Engineering-3/RCM-Comm/README.md

RCM-Comm
========================

RCM-Comm

This is an interface board that brings wireless communication to the RCM Control Stack. The RCM-Comm accepts the [Lantronix XPico WiFi Embedded Device Server](https://www.lantronix.com/wp-content/uploads/pdf/xPico-Wi-Fi_UG.pdf). Please see [Engineering3](http://engineering3.org/) for more information on the complete RCM Control Stack project.

Repository Contents
-------------------

* **/RCM-Comm_v1** Eagle schematic/board files, BOM, gerbers

Version History
---------------
* [RCM-Comm_v1](https://github.com/Engineering-3/RCM-Comm/tree/master/RCM-Comm_v1) - First public version - version 1 

License Information
-------------------
Hardware is released under [Solderpad Hardware License v0.51](http://solderpad.org/licenses/SHL-0.51/).
Distributed as-is; no warranty is given.

Getting Started Help
--------------------
This is a Plug-n-Play board.
