Engineering-3/RCM-Comm/RCM-Comm_v3_E/README - RCM-COMM PCB Specification.txt

RCM-COMM PCB Specification
-------------------------------

BOARD STACK:

1. Copper Top
2. Copper Bottom

SILKSCREENS:

1.  Both Layers

PASTE MASKS:

1. Top Layer

BOARD MATERIALS:

RoHS Compliant: YES
Copper: 1oz
Finish: Immersion Gold
Material: FR-406
Thickness: 62 mil
Tg>170
Soldermask: SMOBC BLUE
Silkscreen: White

BOARD TESTING:

Electrical Test: YES
