Engineering-3/RCM-Comm/RCM-Comm_v3_E/RCM-Comm_v3_E_bottom_render.png

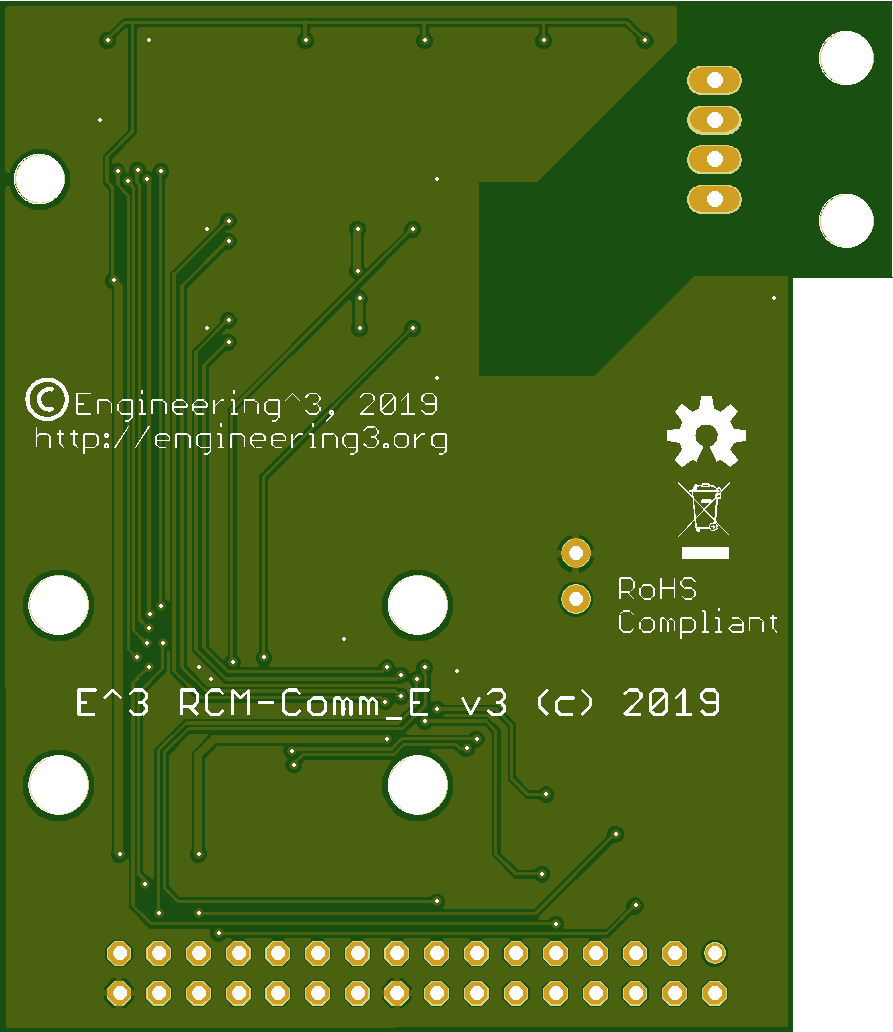
RCM-Comm_v3_E/RCM-Comm_v3_E_bottom_render.png
