Engineering-3/RCM-Comm/RCM-Comm_v3_W/BoardBottomRender.png

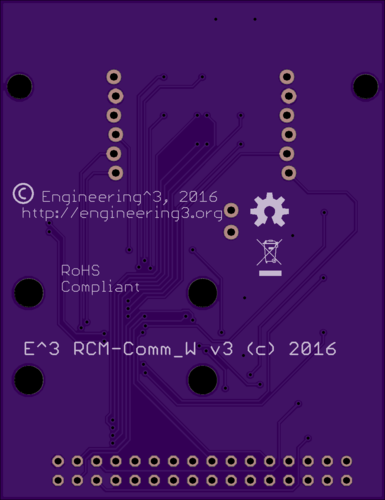
RCM-Comm_v3_W/BoardBottomRender.png
