Engineering-3/RCM-Comm/RCM-Comm_v3_W/BoardTopRender.png

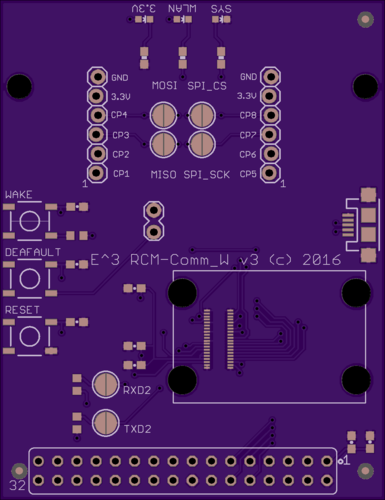
RCM-Comm_v3_W/BoardTopRender.png
