Engineering-3/RCM-Comm/RCM-Comm_v4/RCM-Comm_v4b_bottom_render.png

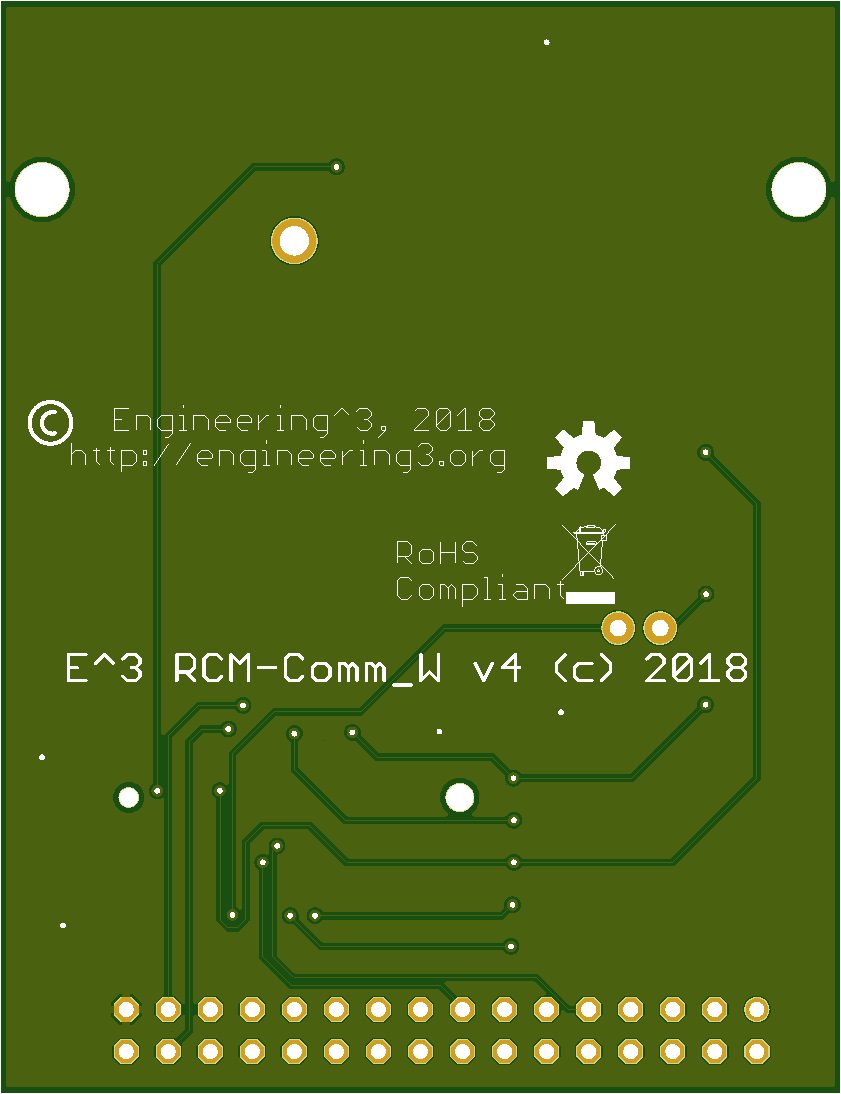
RCM-Comm_v4/RCM-Comm_v4b_bottom_render.png
