Engineering-3/RCM-Comm/RCM-Comm_v3_E/RCM-Comm_v3_E-BOM.xlsx

RCM-Comm_v3 _E-BOM |  |  |  |  |  |  | Price | Extended price
Reference | Quantity | Description | Manufacturer | Partnumber | Dist Part Number | Distributor
J1 | 1 | SOCKET, 2.54MM, 2X16POS | SAMTEC | SSQ-116-03-G-D |  | Avnet Express | $4.18 | $4.18
U1 | 1 | Lantronix Xpico WiFi module | Lantronix | XPW100100B-01 |  | Mouser | $29.56 | $29.56
FX1 | 1 | MODULE XFRMR LAN 10/100B-TX SMD | Bel Fuse Inc | S558-5999-T7-F | 507-1459-1-ND | Digikey | $2.71 | $2.71
R1, R2 | 2 | 2.7K 0603 RES | Yageo | RC0603JR-072K7L |  | Digikey | $0.10 | $0.20
R4 | 1 | 1K 0603 RES | Yageo | RC0603JR-071KL |  | Digikey | $0.10 | $0.10
S1, S2, S3 | 3 | tact switch | TE Connectivity | FSMCTTR |  | Digikey | $0.63 | $1.89
J4 | 1 | .1" 2-pin male header | 3M | 961102-6404-AR |  | Digikey | $0.16 | $0.16
C6, C7 | 2 | CAP CER 10UF 0603 | Samsung | CL10A106MQ8NNNC |  | Digikey | $0.18 | $0.36
R3, R5, R6 | 3 | RES 330 OHM 1/4W 5% 0603 SMD | Rhom Semiconductor | ESR03EZPJ331 |  | Digikey | $0.03 | $0.09
LED1, LED2, LED3 | 4 | LED SMARTLED GREEN 570NM 0603 | OSRAM Opto Semi | LG L29K-G2J1-24-Z |  | Digikey | $0.36 | $1.44
C1, C2, C4, C5, C8, C9 | 6 | CAP CER 0.1UF 16V 10% X7R 0603 | Murata Electronics | GRM188R71C104KA01D |  | Digikey | $0.10 | $0.60
U1 (connector) | 1 | CONN RCPT 40POS 0.4MM SMD GOLD | Hirose | DF40C(2.0)-40DS-0.4V(51) |  | Digikey | $1.18 | $1.18
xPico module mounting clip | 1 | xPico WiFi mounting clip (comes in box of 50) | Lantronix | XPC100A001-01-B |  | Mouser | $0.35 | $0.35
 |  |  |  |  |  |  |  | $0.00
PCB | 1 |  |  |  |  |  |  | $0.00
 |  |  |  |  |  |  |  | $0.00
 |  |  | Total |  |  |  |  | $42.82
