Engineering-3/RCM-Comm/RCM-Comm_v4/RCM-Comm_v4_BOM.xlsx

RCM-Comm v4 BOM
Item # | Qty | Ref Des | Manufacturer | Mfg Part # | Dist. Part # | Description
1 | 1 | J2 | TE Connectivity AMP Connectors | 2199230-4 | A115904CT-ND | CONN FEMALE 67POS 0.020 GOLD
2 | 1 | J1 | Samtec | SSQ-116-03-G-D | SSQ-116-03-G-D | 2 x 16 .1" female header with long pins
3 | 3 | LED1, LED2, LED3 | Lite-On Inc. | LTST-C193KGKT-5A | 160-1828-1-ND | LED GREEN CLEAR CHIP SMD
4 | 3 | R1, R3, R5 | Yageo | RC0603FR-07330RL | 311-330HRCT-ND | RES SMD 330 OHM 1% 1/10W 0603
5 | 4 | R4, R7, R8, R9, R10 | Yageo | RC0603JR-07100KL | 311-100KGRCT-ND | RES SMD 100K OHM 5% 1/10W 0603
6 | 1 | J3 | Wurth Electronics Inc. | 61300211121 | 732-5315-ND | CONN HEADER VERT 2POS 2.54MM
7 | 6 | C1, C4, C5, C9, C2, C8 | Murata Electronics North America | GRM033R61A104ME15D | 490-5405-1-ND | CAP CER 0.1UF 10V X5R 0201
8 | 3 | S1, S2, S3 | TE Connectivity ALCOSWITCH Switches | FSMCTTR | 450-2133-1-ND | SWITCH TACTILE SPST-NO 0.02A 15V
9 | 1 | Radio | Lantronix | XPC240300S-02 | XPC240300S-02-ND | XPC240300S-02-ND
10 | 1 |  | McMaseter-Carr | 92321A005 (https://www.mcmaster.com/92321A005) | 92321A005 (https://www.mcmaster.com/92321A005) | 18-8 Stainless Steel Unthreaded Spacer, 1/8" OD, 1/8" Long, for Number 0 Screw Size
11 | 1 |  | McMaseter-Carr | 91841A115 (https://www.mcmaster.com/91841A115) | 91841A115 (https://www.mcmaster.com/91841A115) | 18-8 Stainless Steel Hex Nut, 0-80 Thread Size
12 | 1 |  | McMaseter-Carr | 91772A058 (https://www.mcmaster.com/91772A058) | 91772A058 (https://www.mcmaster.com/91772A058) | Passivated 18-8 Stainless Steel Pan Head Phillips Screw, 0-80 Thread, 7/32" Long
13 | 2 | C6, C7 | Samsung Electro-Mechanics | CL21A106KOQNNNG | 1276-6455-1-ND | CAP CER 10UF 16V X5R 0805
