Engineering-3/RCM-Comm/RCM-Comm_v4/RCM-Comm_v4_sch.pdf

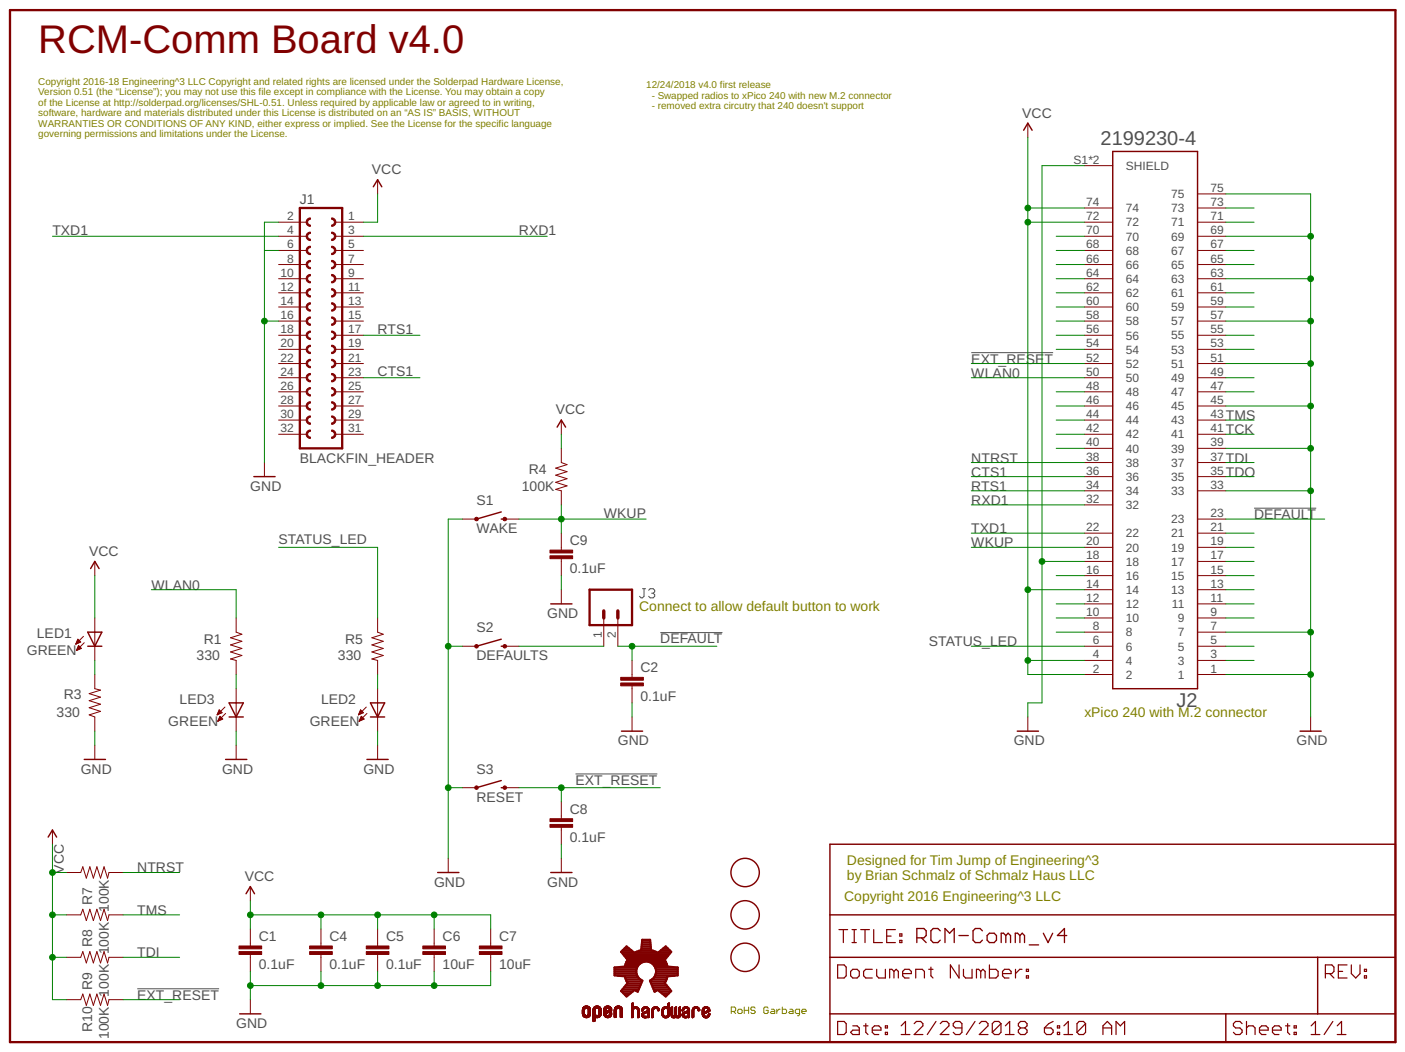
[picture p12: page 1]

Copyright 2016-18 Engineering^3 LLC Copyright and related rights are licensed under the Solderpad Hardware License, Version 0.51 (the “License”); you may not use this file except in compliance with the License. You may obtain a copy of the License at http://solderpad.org/licenses/SHL-0.51. Unless required by applicable law or agreed to in writing, software, hardware and materials distributed under this License is distributed on an “AS IS” BASIS, WITHOUT WARRANTIES OR CONDITIONS OF ANY KIND, either express or implied. See the License for the specific language

12/24/2018 v4.0 first release
- Swapped radios to xPico 240 with new M.2 connector
- removed extra circutry that 240 doesn't support

governing permissions and limitations under the License.

72
70 68 66 64 62 60 58 56 54 52

Connect to allow default button to work

Designed for Tim Jump of Engineering^3
by Brian Schmalz of Schmalz Haus LLC
Copyright 2016 Engineering^3 LLC
