Engineering-3/RCM-Comm/RCM-Comm_v3_E/RCM-Comm_v3_E_brd.pdf

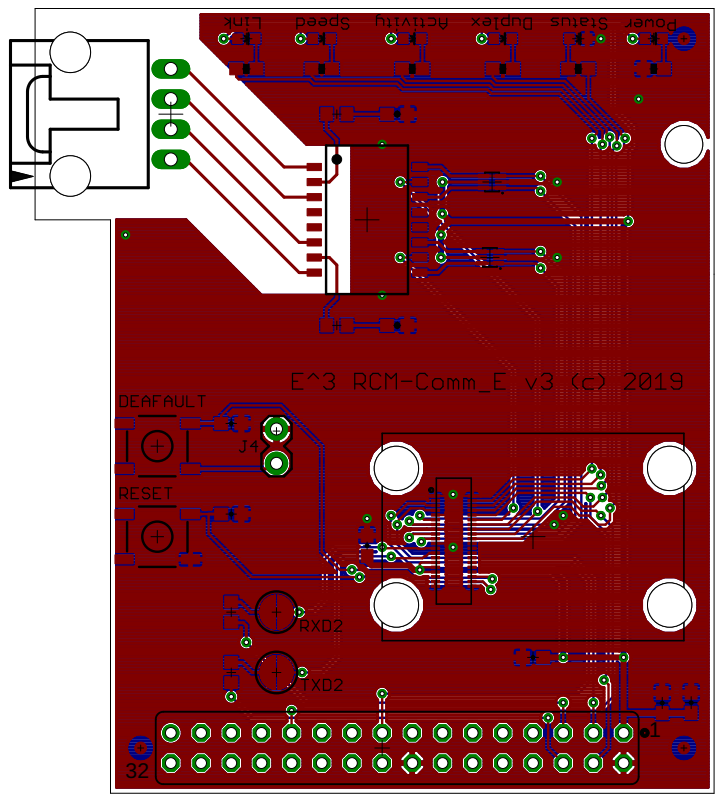
[picture p13: page 1]
