Engineering-3/RCM-Comm/RCM-Comm_v4/RCM-Comm_v4_brd.pdf

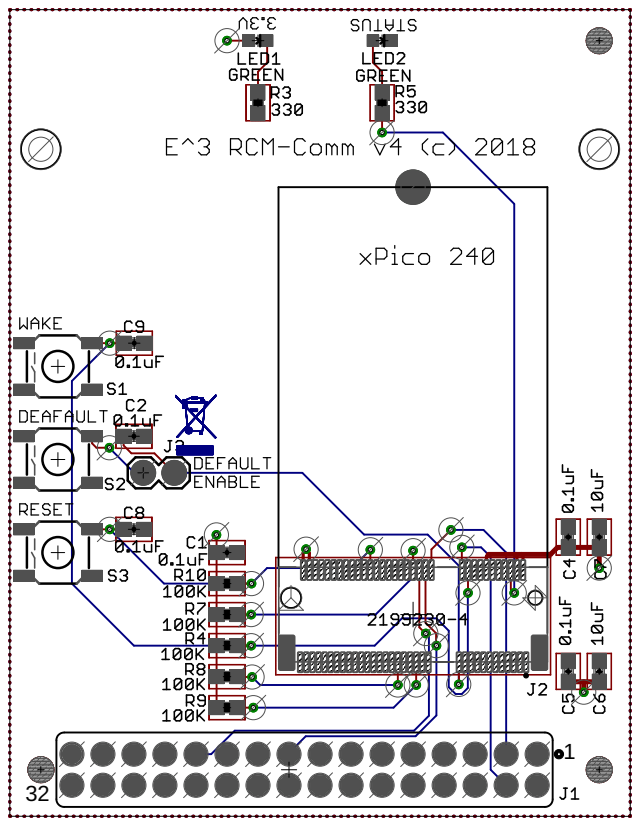
[picture p14: page 1]
