Engineering-3/RCM-Comm/RCM-Comm_v3_W/RCM-Comm_v3_W_brd.pdf

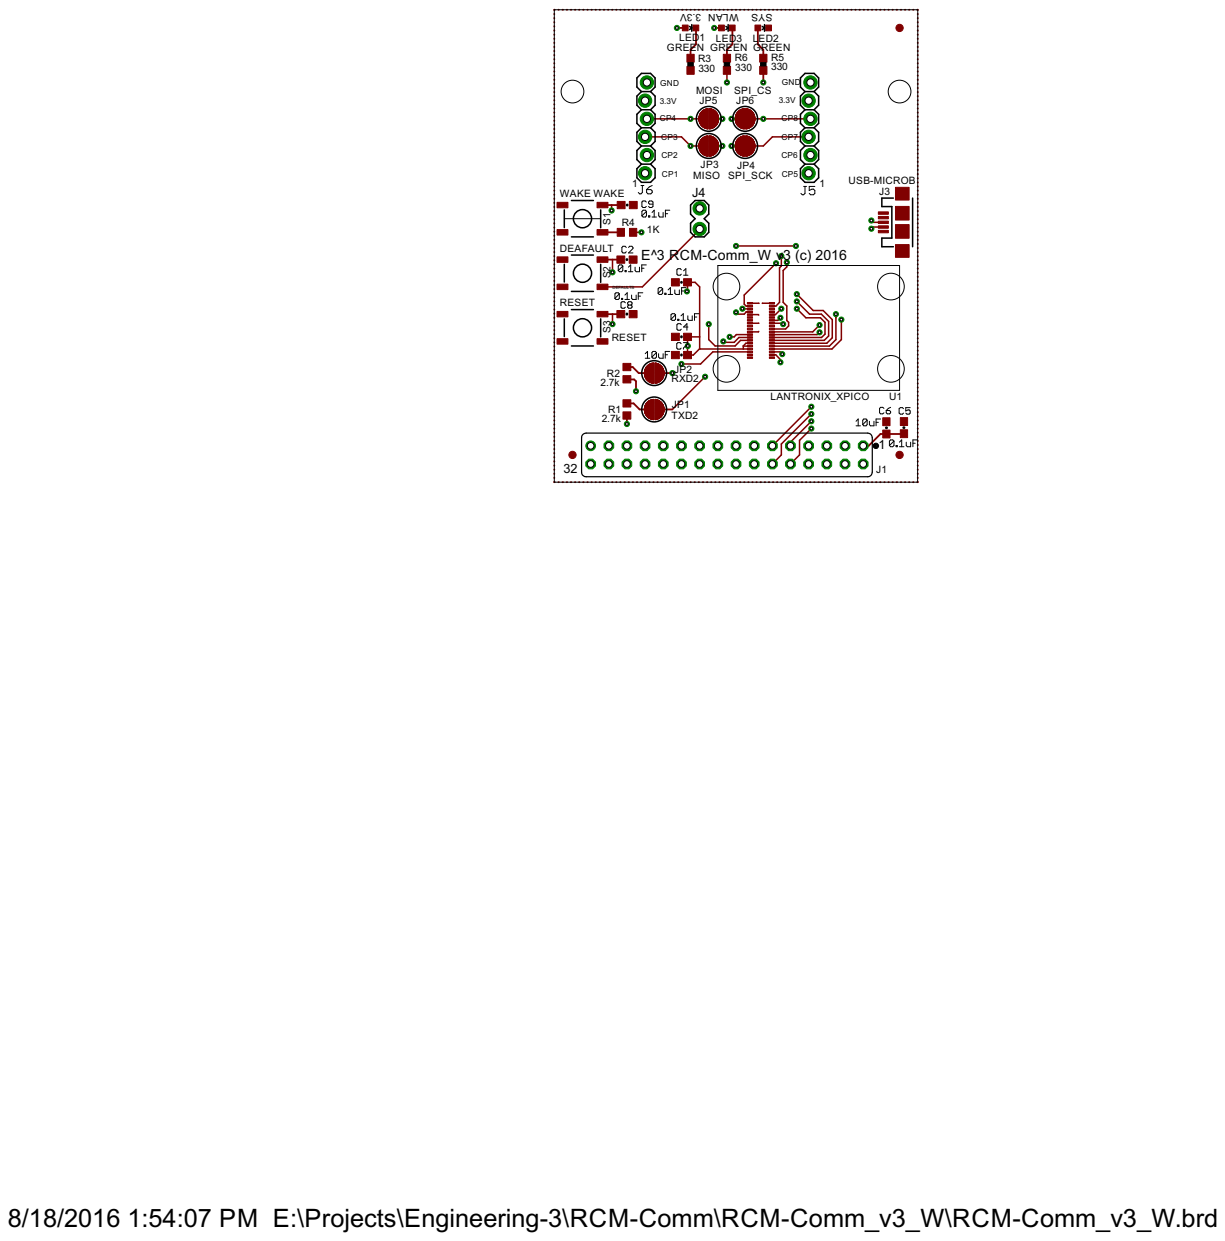
[picture p15: page 1]

8/18/2016 1:54:07 PM E:\Projects\Engineering-3\RCM-Comm\RCM-Comm_v3_W\RCM-Comm_v3_W.brd
