Engineering-3/RCM-Comm/RCM-Comm_v3_W/RCM-Comm_v3_W_brd_top.pdf

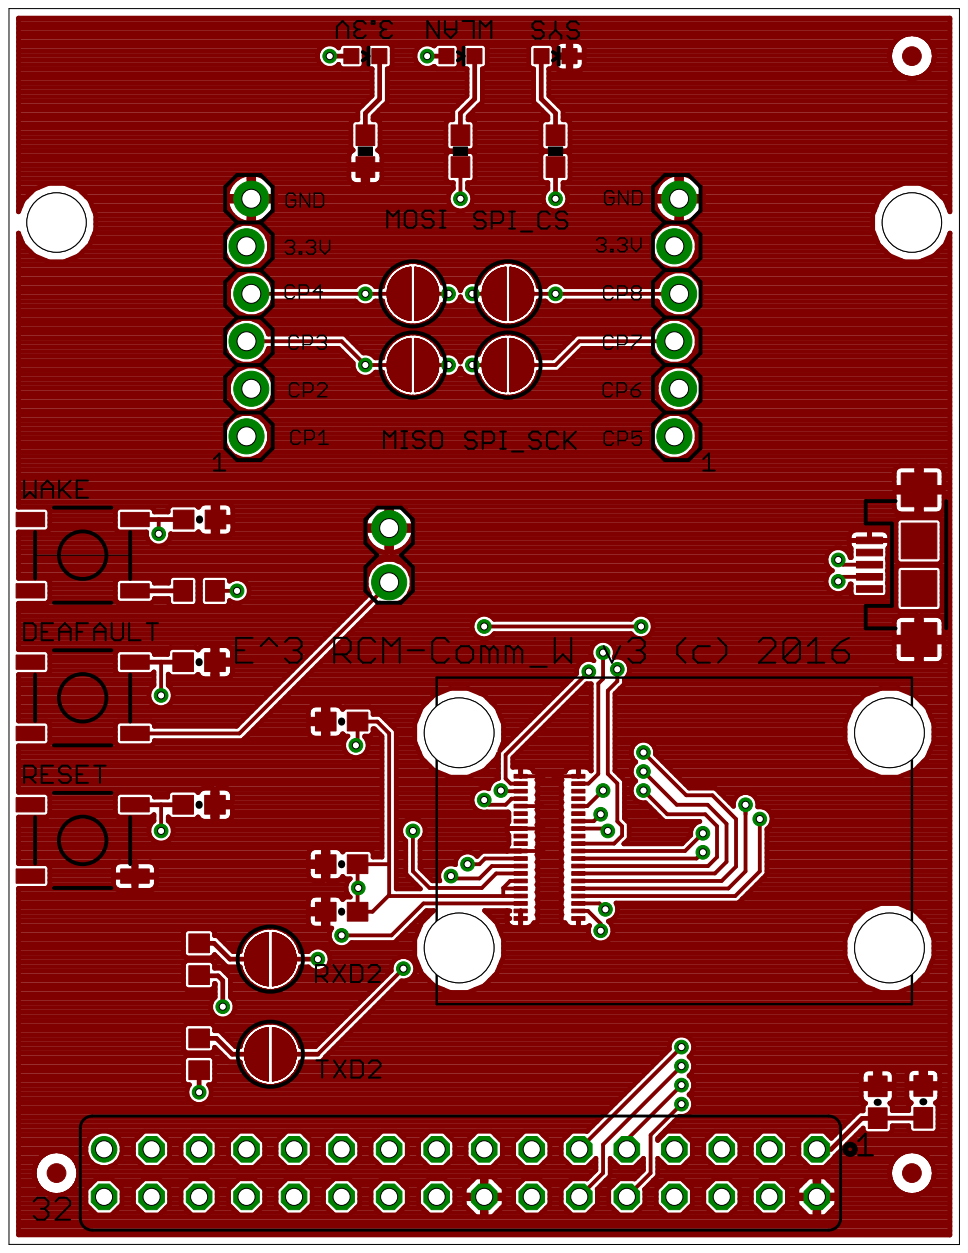
[picture p16: page 1]
