Engineering-3/RCM-Comm/RCM-Comm_v2_W/RCM-Comm_v2_W_brd.pdf

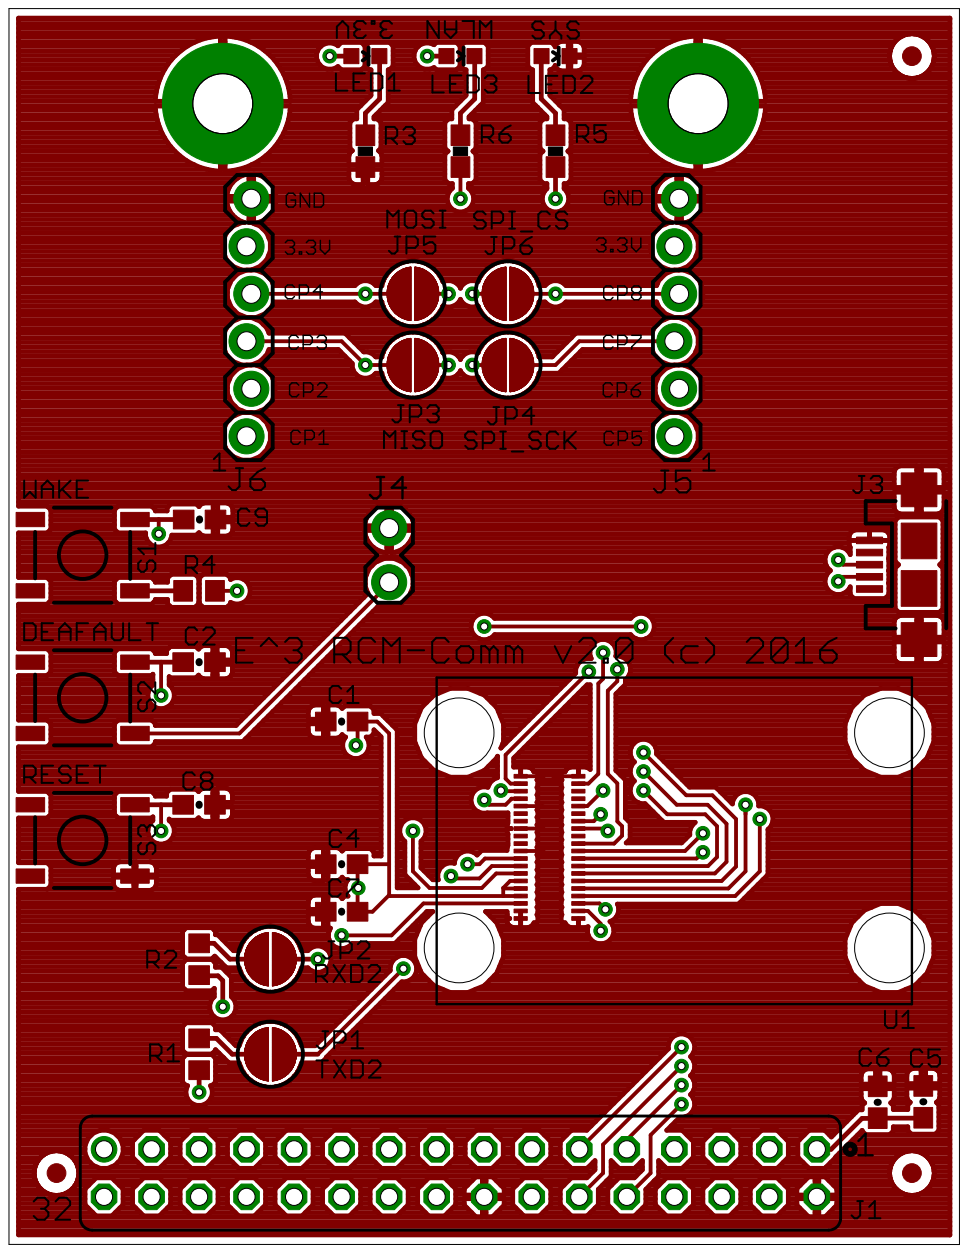
[picture p17: page 1]
