Engineering-3/RCM-Comm/RCM-Comm_v2_W/RCM-Comm_v2_W_sch.pdf

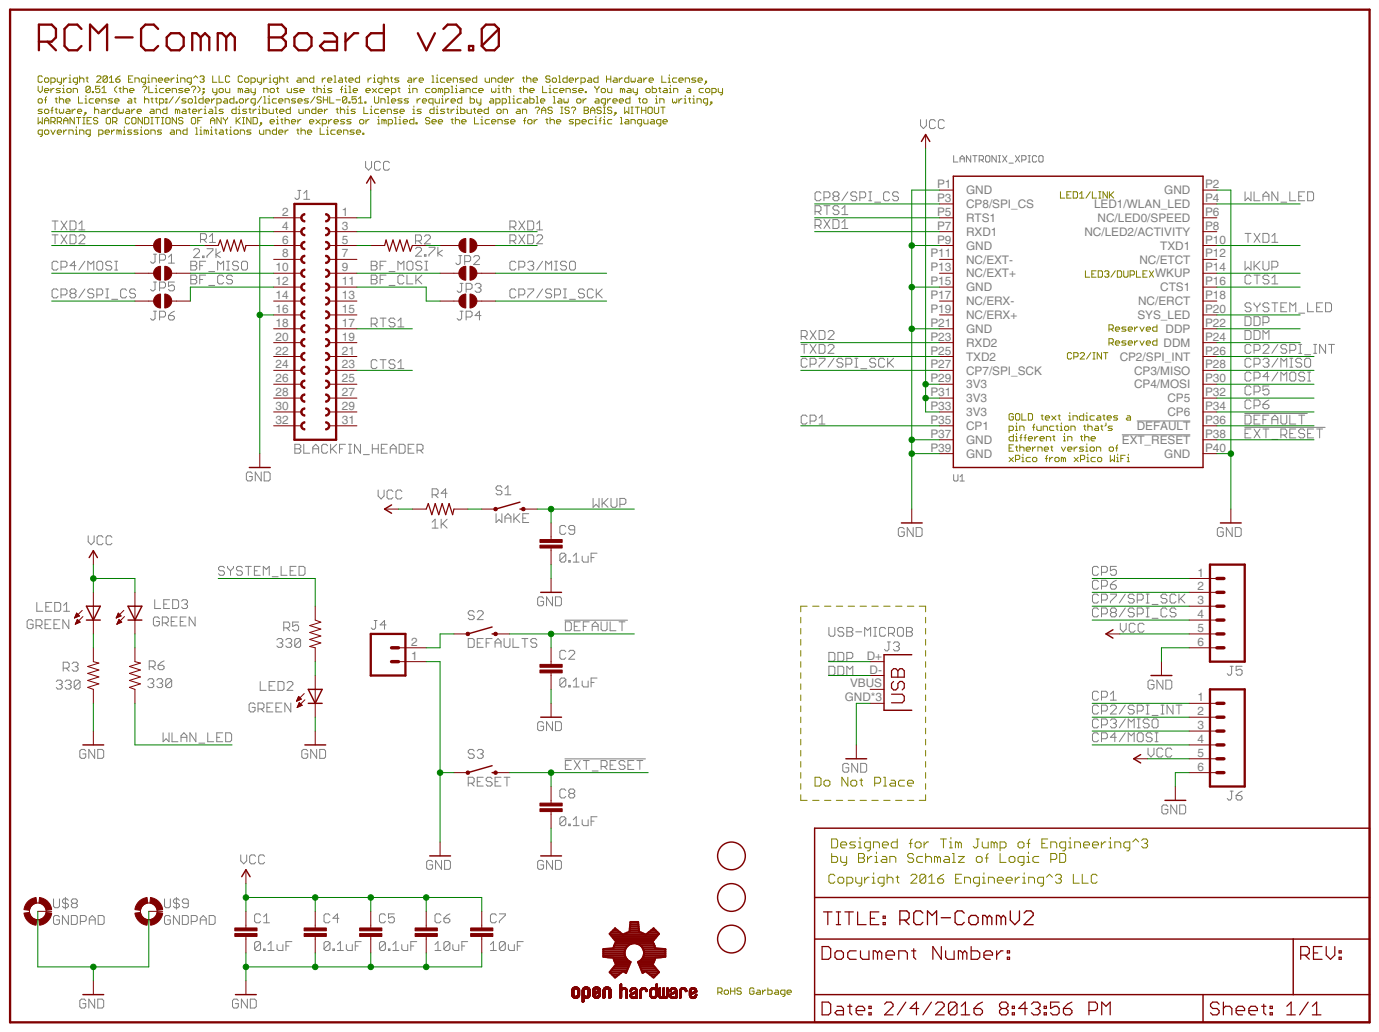
[picture p18: page 1]
