Engineering-3/RCM-Comm/RCM-Comm_v1/RCM-comm_v1_brd.pdf

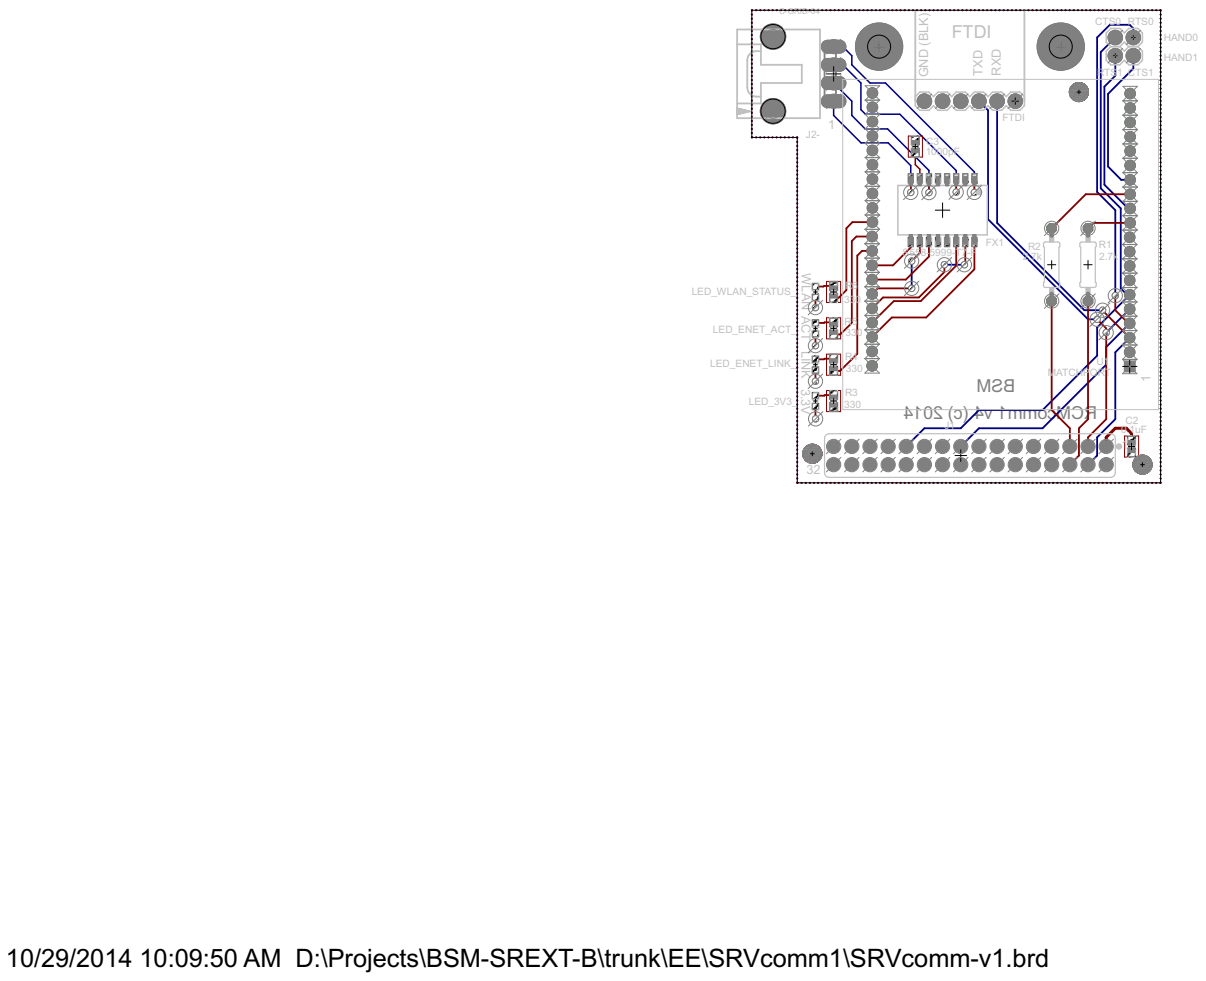
[picture p19: page 1]

10/29/2014 10:09:50 AM D:\Projects\BSM-SREXT-B\trunk\EE\SRVcomm1\SRVcomm-v1.brd
