Engineering-3/RCM-Comm/RCM-Comm_v1/RCM-comm_v1_sch.pdf

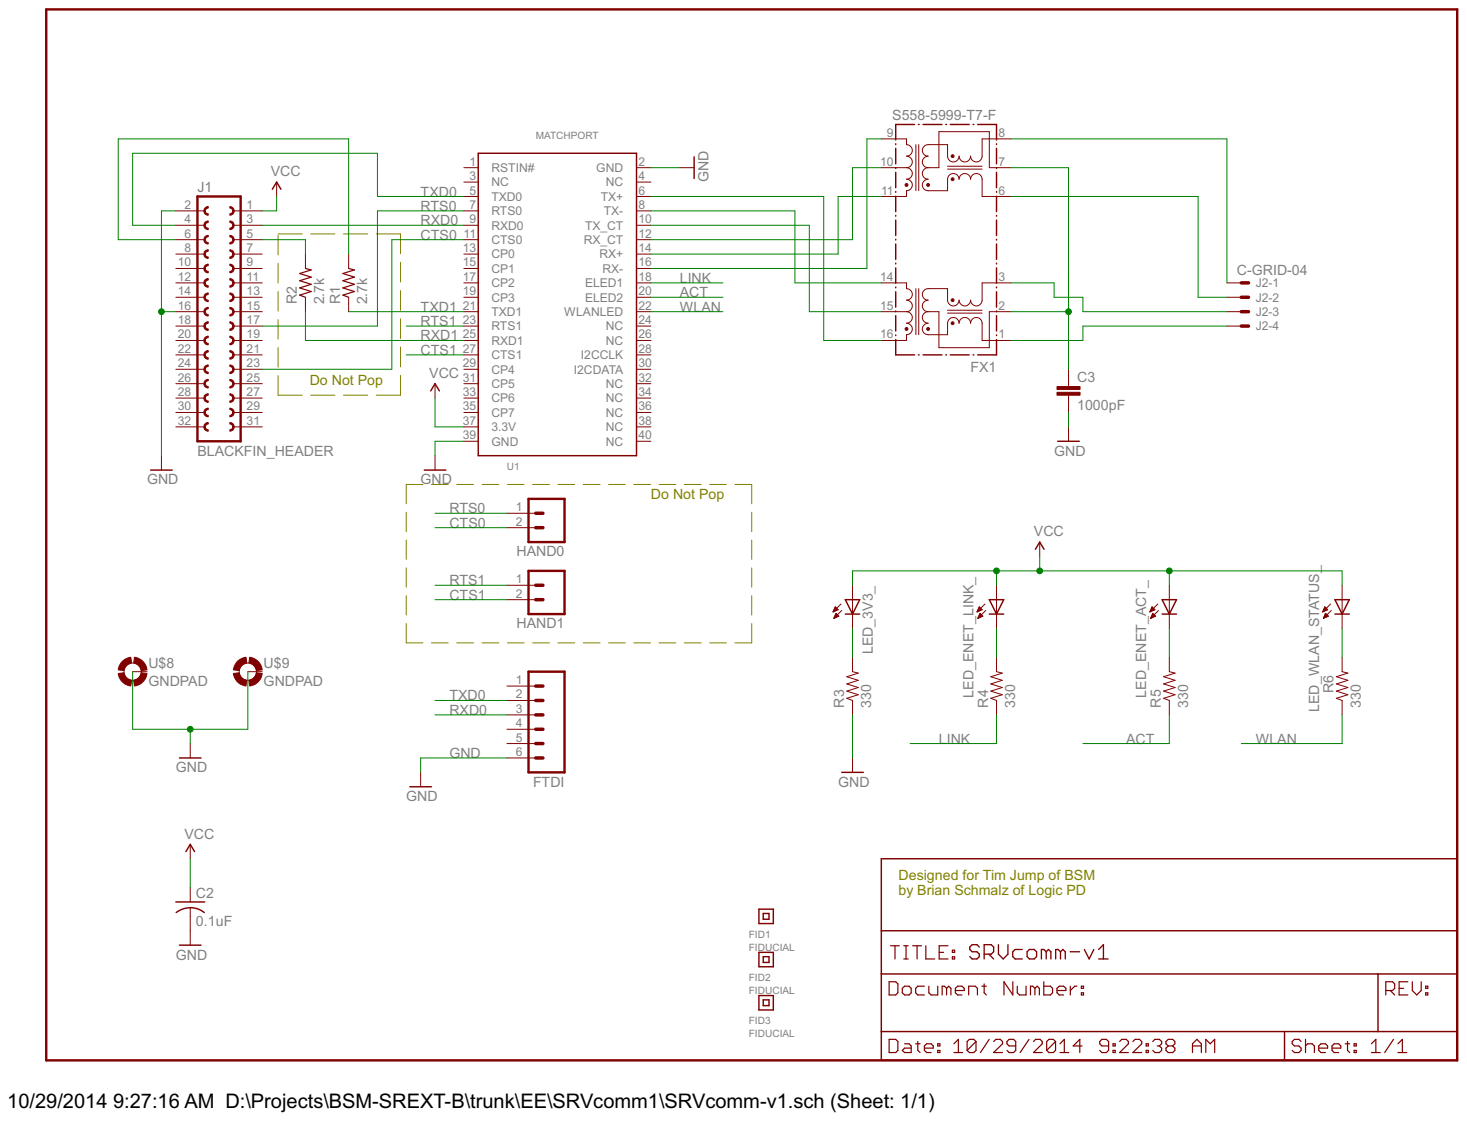
[picture p20: page 1]

Designed for Tim Jump of BSM
by Brian Schmalz of Logic PD

10/29/2014 9:27:16 AM D:\Projects\BSM-SREXT-B\trunk\EE\SRVcomm1\SRVcomm-v1.sch (Sheet: 1/1)
