Engineering-3/RCM-Comm/RCM-Comm_v3_E/RCM-Comm_v3_E.brd

## EAGLE design RCM-Comm_v3_E/RCM-Comm_v3_E.brd (2019-03-16)

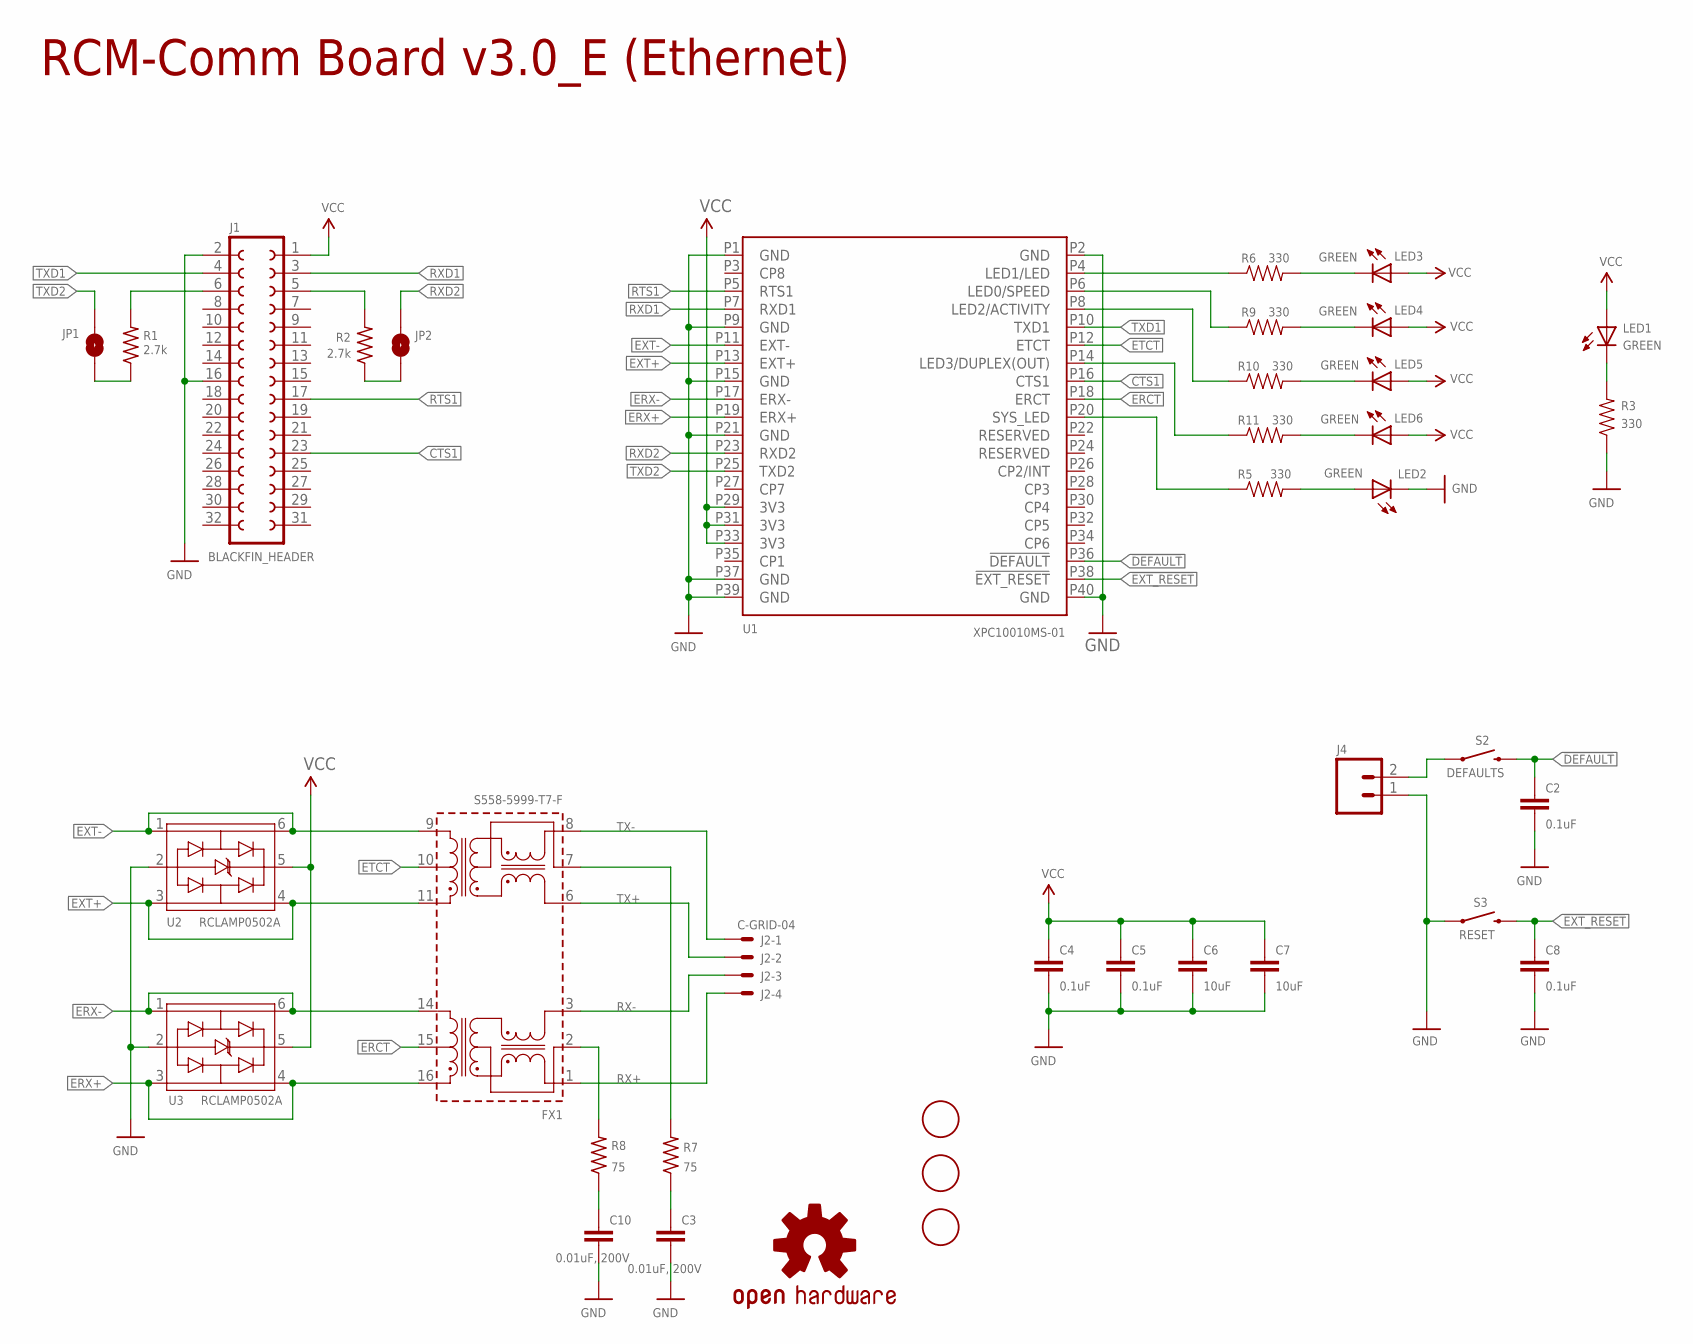
[picture p21: schematic RCM-Comm_v3_E.sch]

Parts:
C2, C4, C5, C8: 0.1uF; 0603-CAP
C3, C10: 0.01uF, 200V; 0603-CAP
C6, C7: 10uF; 0603-CAP
FID1, FID2, FID3: FIDUCIAL; FIDUCIAL_1MM
FX1: S558-5999-T7-F; N5
J1: BLACKFIN_HEADER; 2X16
J2-: C-GRID-04; 70555-04
J4: M02LOCK; 1X02_LOCK
JP1, JP2: JUMPER-PAD-2-NOROUND; PAD-JUMPER-2-NO_YES_SILK_ROUND
LED1, LED2, LED3, LED4, LED5, LED6: GREEN; LED-0603
LOGO1: OSHW-LOGOM; OSHW-LOGO-M
R1, R2: 2.7k; R0603
R3, R5, R6, R9, R10, R11: 330; 0603-RES
R7, R8: 75; R0603
S2: DEFAULTS; TACTILE-SWITCH-SMD
S3: RESET; TACTILE-SWITCH-SMD
U1: XPC10010MS-01; LANTRONIX_XPICO
U2, U3: RCLAMP0502A; SC-89
U$3: ROHS_GARBAGE; ROHS_GARBAGE_5MM

Connections:
!DEFAULT!: C2.1, S2.3 (2), U1.P36 (!DEFAULT!)
!EXT_RESET!: C8.1, S3.3 (2), U1.P38 (!EXT_RESET!)
CTS1: J1.23 (GP6), U1.P16 (CTS1)
ERCT: FX1.15, U1.P18 (ERCT)
ERX+: FX1.16, U1.P19 (ERX+), U3.3, U3.4
ERX-: FX1.14, U1.P17 (ERX-), U3.1, U3.6
ETCT: FX1.10, U1.P12 (ETCT)
EXT+: FX1.11, U1.P13 (EXT+), U2.3, U2.4
EXT-: FX1.9, U1.P11 (EXT-), U2.1, U2.6
GND: C2.2, C3.2, C4.2, C5.2, C6.2, C7.2, C8.2, C10.2, J1.2 (GND), J1.16 (GND16), J4.1, LED2.C, R3.1, S3.1, U1.P1 (GND), U1.P2 (GND), U1.P9 (GND), U1.P15 (GND), U1.P21 (GND), U1.P37 (GND), U1.P39 (GND), U1.P40 (GND), U2.2, U3.2
LED0_SPEED: R9.1, U1.P6 (LED0/SPEED)
LED1_LINK: R6.1, U1.P4 (LED1/LED)
LED2_ACTIVITY: R10.1, U1.P8 (LED2/ACTIVITY)
LED3_DUPLEX: R11.1, U1.P14 (LED3/DUPLEX(OUT))
unnamed: J4.2, S2.1
unnamed: JP1.2, R1.1
unnamed: LED1.C, R3.2
unnamed: JP2.1, R2.1
unnamed: LED2.A, R5.2
unnamed: FX1.2, R8.2
unnamed: LED3.C, R6.2
unnamed: C10.1, R8.1
unnamed: C3.1, R7.1
unnamed: FX1.7, R7.2
unnamed: LED6.C, R11.2
unnamed: LED5.C, R10.2
unnamed: LED4.C, R9.2
RTS1: J1.17 (GP0), U1.P5 (RTS1)
RX+: FX1.1, J2-.4
RX-: FX1.3, J2-.3
RXD1: J1.3 (TX0), U1.P7 (RXD1)
RXD2: JP2.2, U1.P23 (RXD2)
RXD2_J1: J1.5 (TX1), R2.2
SYSTEM_LED: R5.1, U1.P20 (SYS_LED)
TX+: FX1.6, J2-.2
TX-: FX1.8, J2-.1
TXD1: J1.4 (RX0), U1.P10 (TXD1)
TXD2: JP1.1, U1.P25 (TXD2)
TXD2_J1: J1.6 (RX1), R1.2
VCC: C4.1, C5.1, C6.1, C7.1, J1.1 (3.3V), LED1.A, LED3.A, LED4.A, LED5.A, LED6.A, U1.P29 (3V3), U1.P31 (3V3), U1.P33 (3V3), U2.5, U3.5

Notes on the sheet:
RCM-Comm Board v3.0_E (Ethernet)

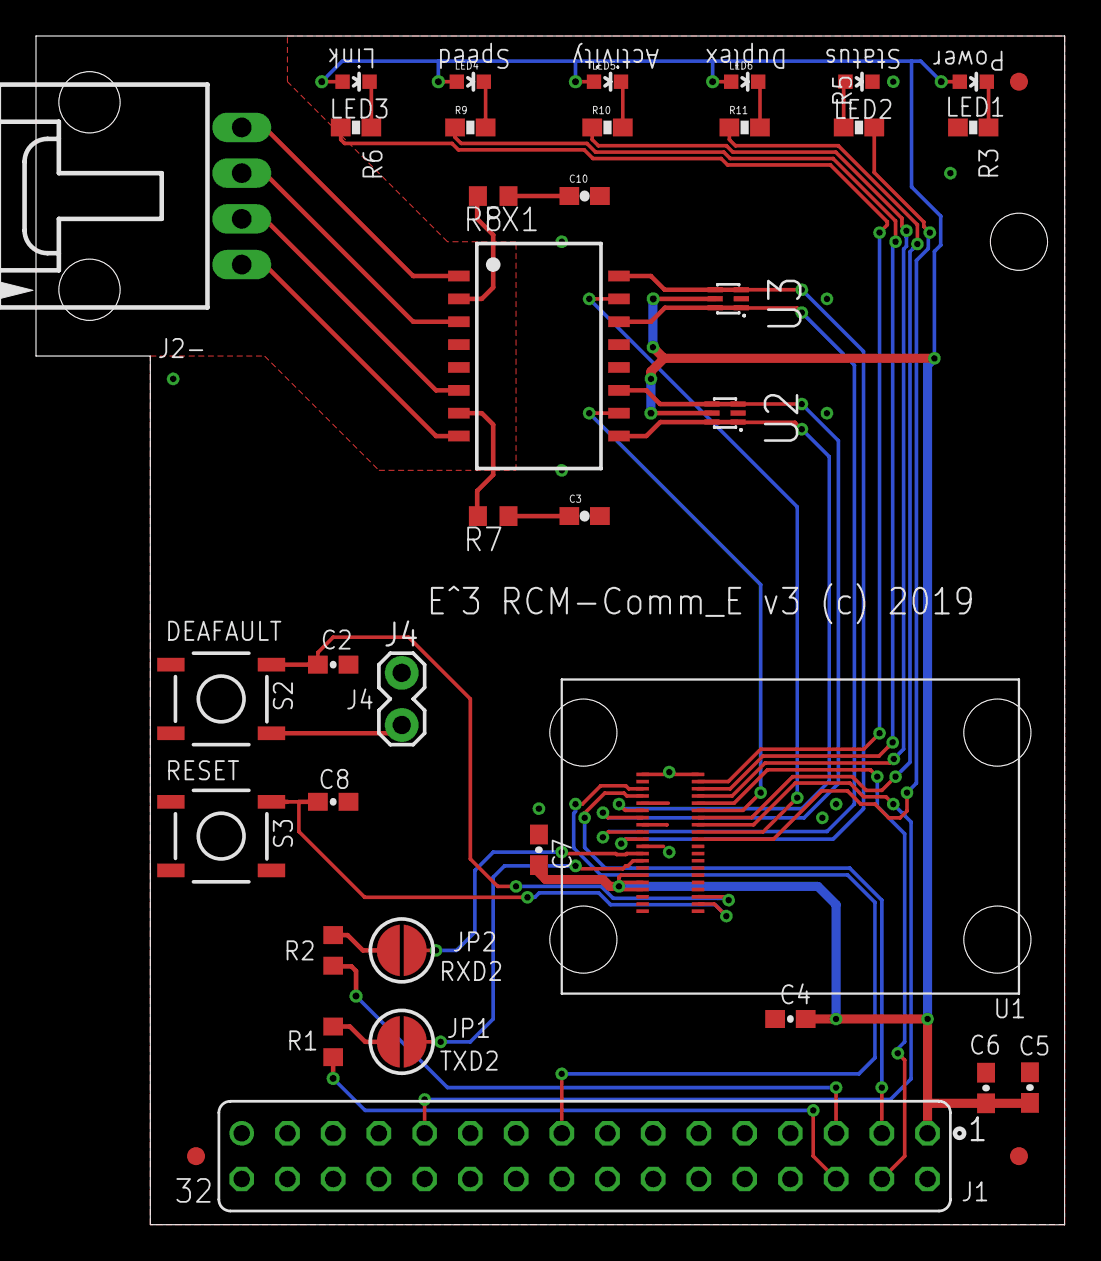
[picture p22: board RCM-Comm_v3_E.brd from above]

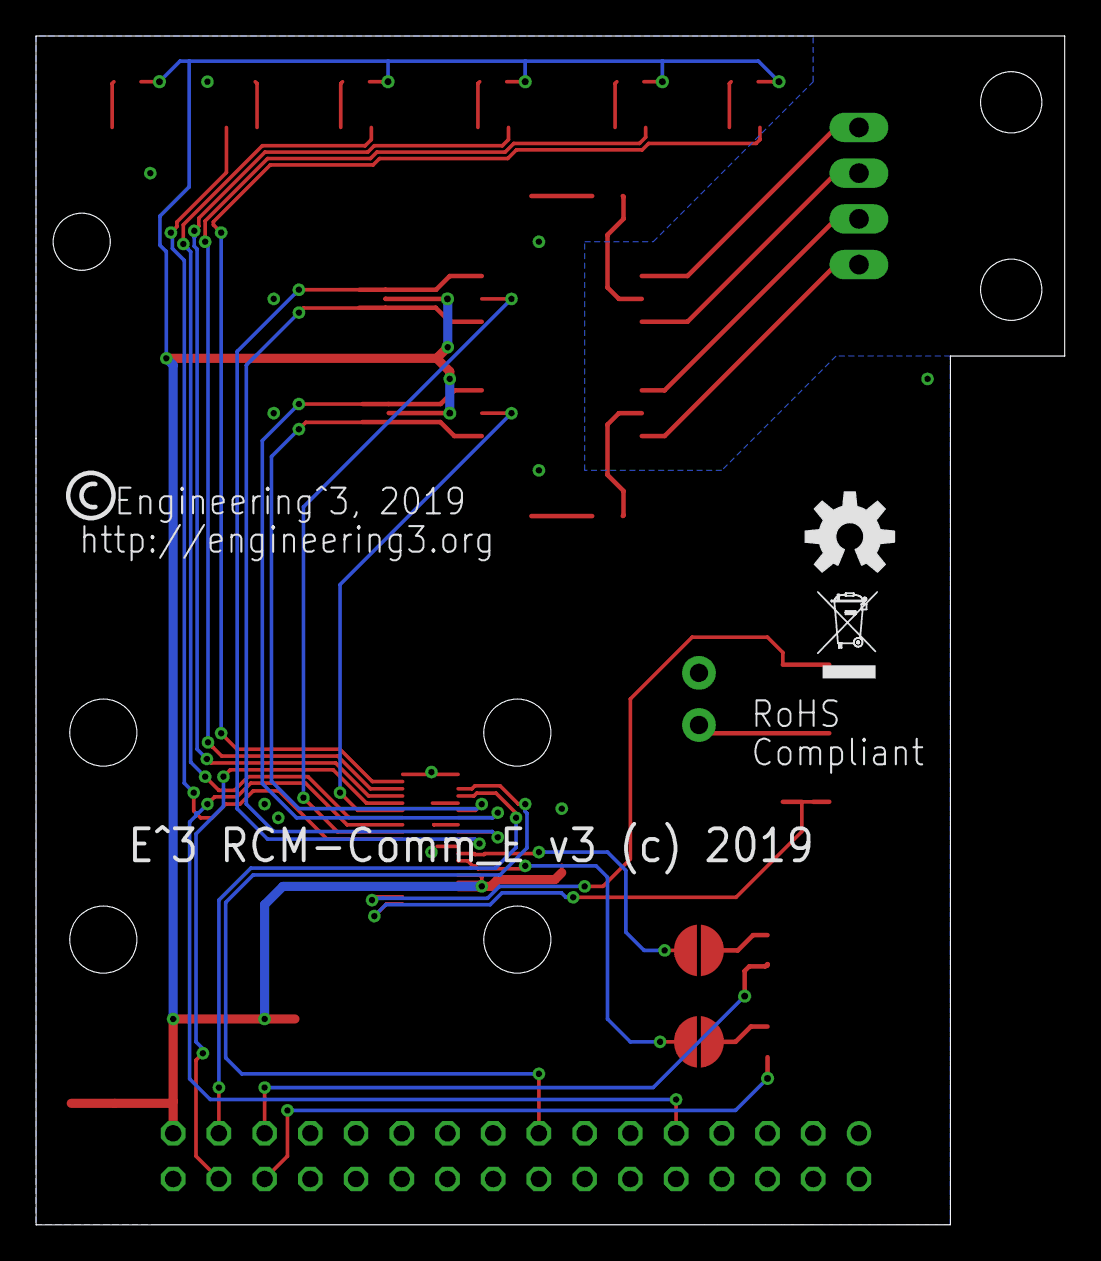
[picture p23: board RCM-Comm_v3_E.brd from below]

Board: 2 copper layers, 57.2 x 66.0 mm, 40 parts (2 on the bottom side), 40 nets.
