Engineering-3/RCM-Comm/RCM-Comm_v4/RCM-Comm_v4.brd

## EAGLE design RCM-Comm_v4/RCM-Comm_v4.brd (2019-01-02)

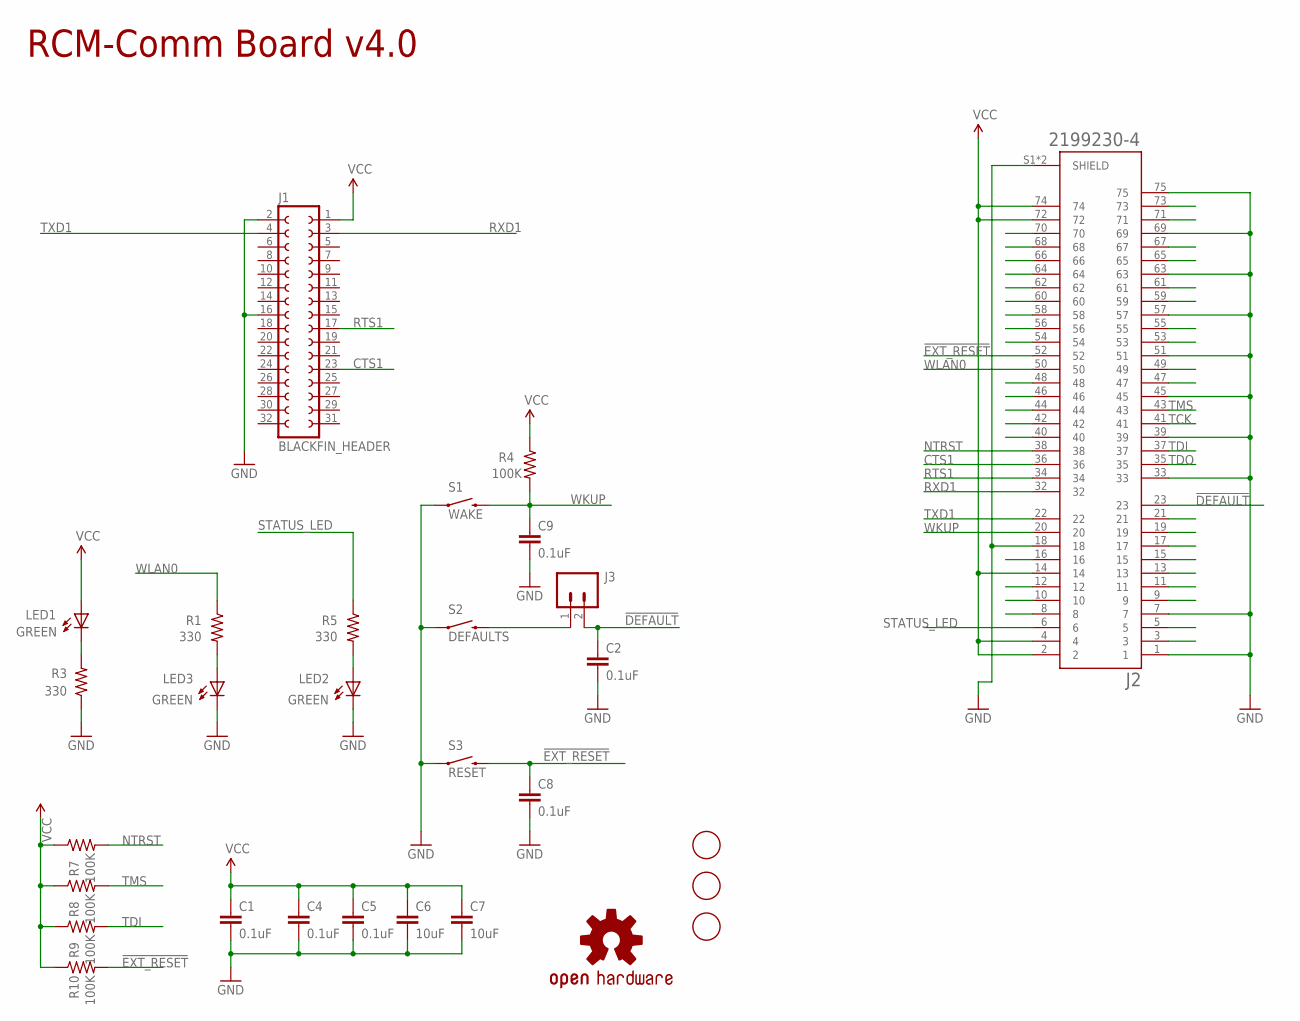
[picture p24: schematic RCM-Comm_v4.sch]

Parts:
C1, C2, C4, C5, C8, C9: 0.1uF; 0603-CAP
C6, C7: 10uF; 0603-CAP
FID1, FID2, FID3: FIDUCIAL; FIDUCIAL_1MM
J1: BLACKFIN_HEADER; 2X16
J2: 2199230-4; TE_2199230-4
J3: CONN_02; 1X02
LED1, LED2, LED3: GREEN; LED-0603
LOGO1: OSHW-LOGOM; OSHW-LOGO-M
R1, R3, R5: 330; 0603-RES
R4, R7, R8, R9, R10: 100K; 0603-RES
S1: WAKE; TACTILE-SWITCH-SMD
S2: DEFAULTS; TACTILE-SWITCH-SMD
S3: RESET; TACTILE-SWITCH-SMD
U$3: ROHS_GARBAGE; ROHS_GARBAGE_5MM

Connections:
!DEFAULT!: C2.1, J2.23, J3.2
!EXT_RESET!: C8.1, J2.52, R10.2, S3.3 (2)
CTS1: J1.23 (GP6), J2.36
GND: C1.2, C2.2, C4.2, C5.2, C6.2, C7.2, C8.2, C9.2, J1.2 (GND), J1.16 (GND16), J2.1, J2.7, J2.18, J2.33, J2.39, J2.45, J2.51, J2.57, J2.63, J2.69, J2.75, J2.S1 (SHIELD), J2.S2 (SHIELD), LED2.C, LED3.C, R3.1, S1.1, S2.1, S3.1
unnamed: J3.1, S2.3 (2)
unnamed: LED3.A, R1.2
unnamed: LED1.C, R3.2
unnamed: LED2.A, R5.2
NTRST: J2.38, R7.2
RTS1: J1.17 (GP0), J2.34
RXD1: J1.3 (TX0), J2.32
STATUS_LED: J2.6, R5.1
TCK: J2.41
TDI: J2.37, R9.2
TDO: J2.35
TMS: J2.43, R8.2
TXD1: J1.4 (RX0), J2.22
VCC: C1.1, C4.1, C5.1, C6.1, C7.1, J1.1 (3.3V), J2.2, J2.4, J2.14, J2.72, J2.74, LED1.A, R4.1, R7.1, R8.1, R9.1, R10.1
WKUP: C9.1, J2.20, R4.2, S1.3 (2)
WLAN0: J2.50, R1.1

Notes on the sheet:
RCM-Comm Board v4.0

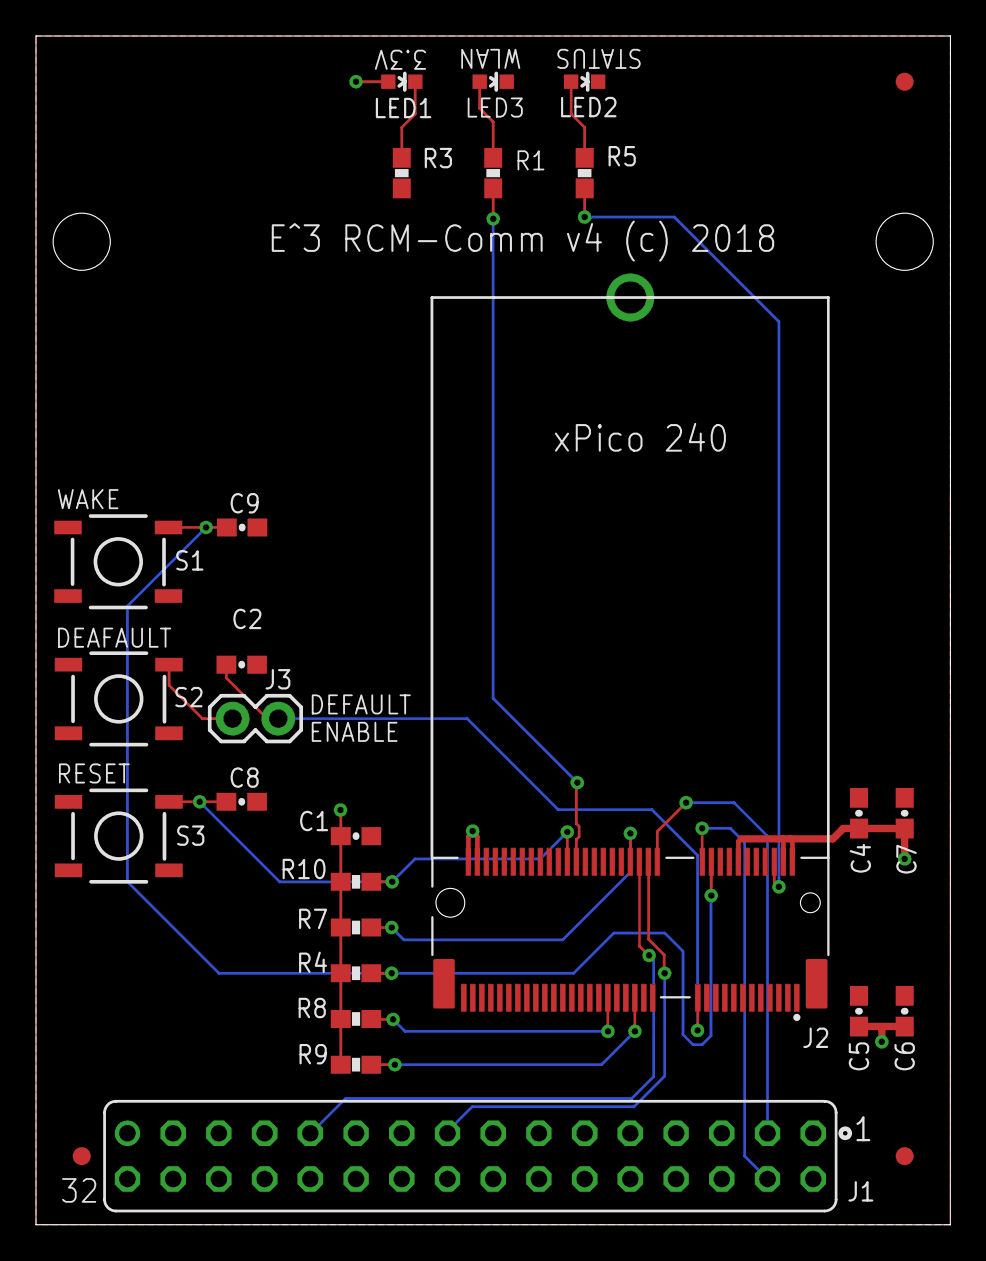
[picture p25: board RCM-Comm_v4.brd from above]

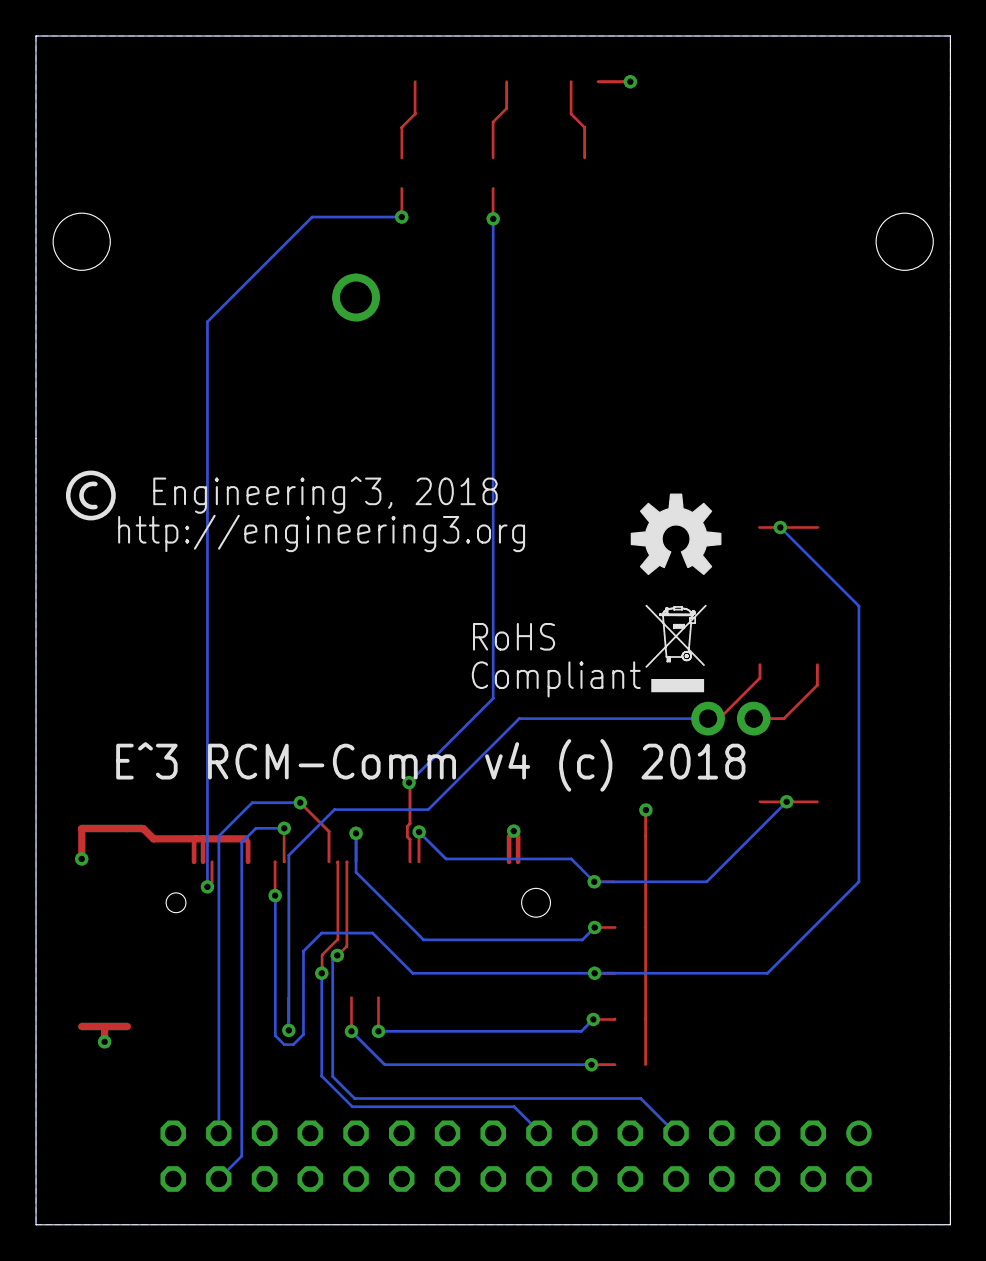
[picture p26: board RCM-Comm_v4.brd from below]

Board: 2 copper layers, 50.8 x 66.0 mm, 30 parts (2 on the bottom side), 18 nets.
