Engineering-3/RCM-Comm/RCM-CommX1/RCM-CommX1.brd

## EAGLE design RCM-CommX1/RCM-CommX1.brd (2016-01-24)

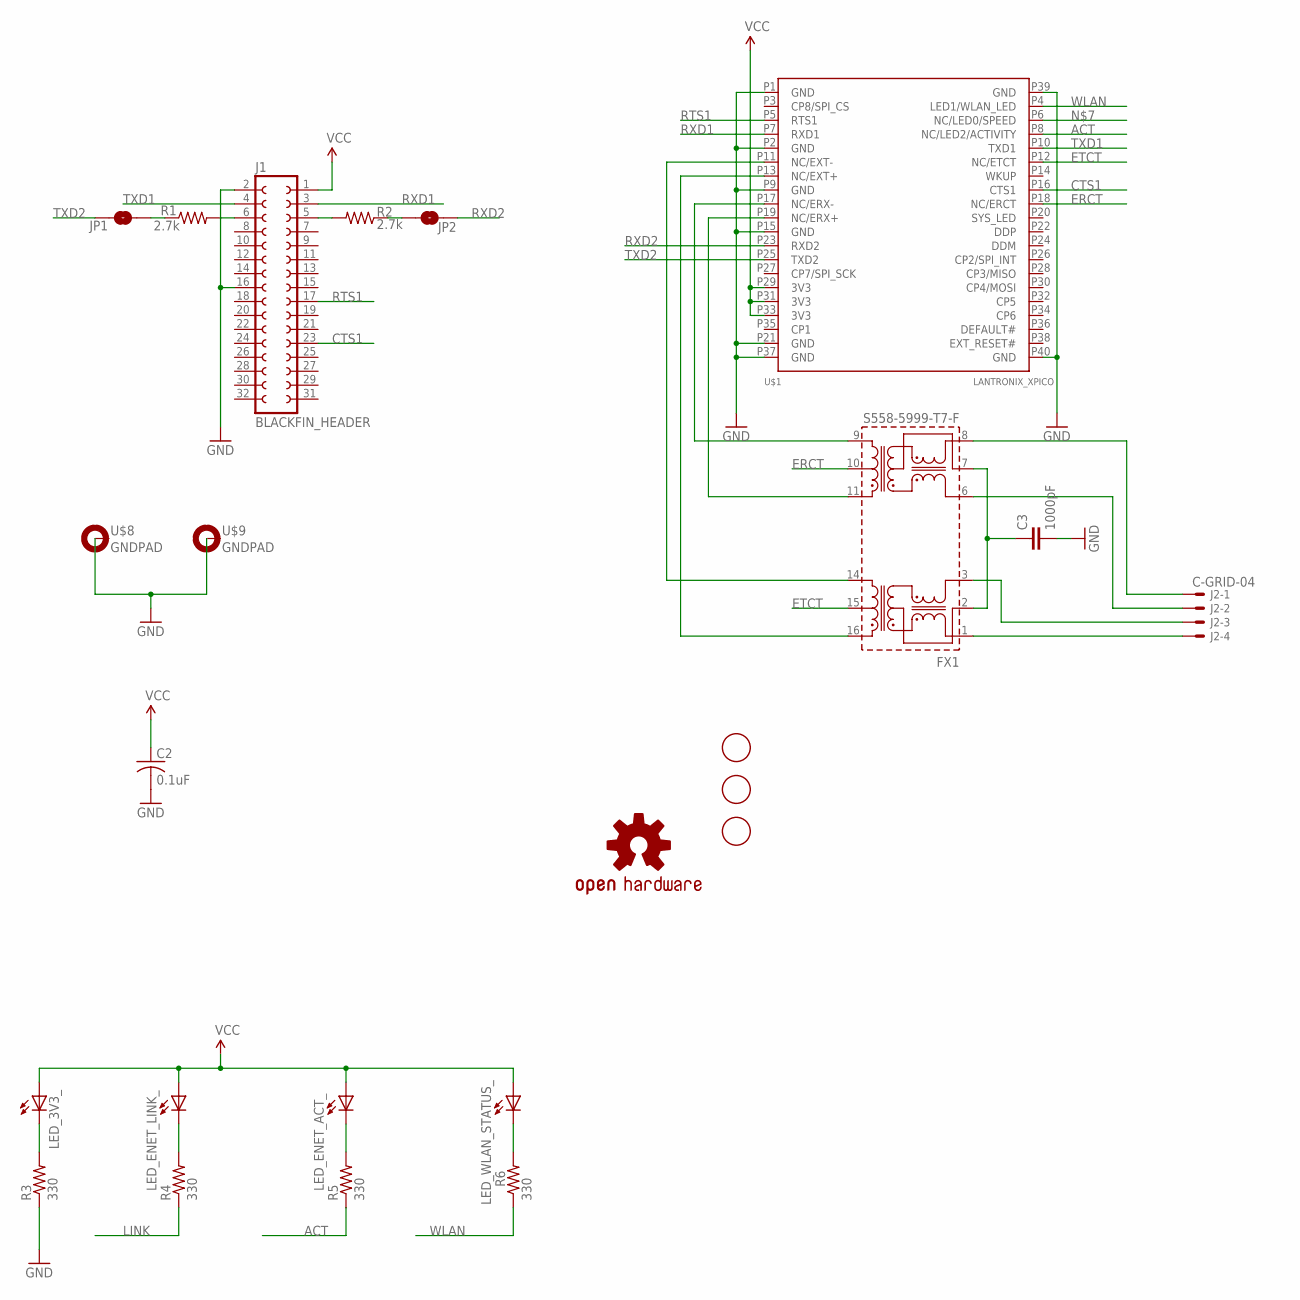
[picture p27: schematic RCM-CommX1.sch]

Parts:
C2: 0.1uF; C0603
C3: 1000pF; 0603-CAP
FID1, FID2, FID3: FIDUCIAL; FIDUCIAL_1MM
FX1: S558-5999-T7-F; N5
J1: BLACKFIN_HEADER; 2X16
J2-: C-GRID-04; 70555-04
JP1, JP2: JUMPER-PAD-2-NOROUND; PAD-JUMPER-2-NO_YES_SILK_ROUND
LED_3V3_: LED0603; LED-0603
LED_ENET_ACT_: LED0603; LED-0603
LED_ENET_LINK_: LED0603; LED-0603
LED_WLAN_STATUS_: LED0603; LED-0603
LOGO1: OSHW-LOGOM; OSHW-LOGO-M
R1, R2: 2.7k; R0603
R3, R4, R5, R6: 330; 0603-RES
U$1: LANTRONIX_XPICO
U$3: ROHS_GARBAGE; ROHS_GARBAGE_5MM
U$8, U$9: GNDPAD

Connections:
ACT: R5.1, U$1.P8 (NC/LED2/ACTIVITY)
CTS1: J1.23 (GP6), U$1.P16 (CTS1)
ERCT: FX1.10, U$1.P18 (NC/ERCT)
ETCT: FX1.15, U$1.P12 (NC/ETCT)
GND: C2.2, C3.2, J1.2 (GND), J1.16 (GND16), R3.1, U$1.P1 (GND), U$1.P2 (GND), U$1.P9 (GND), U$1.P15 (GND), U$1.P21 (GND), U$1.P37 (GND), U$1.P39 (GND), U$1.P40 (GND), U$8.P$1, U$9.P$1
LINK: R4.1
unnamed: C3.1, FX1.2, FX1.7
unnamed: JP1.2, R1.1
unnamed: LED_3V3_.C, R3.2
unnamed: JP2.1, R2.1
unnamed: LED_ENET_LINK_.C, R4.2
unnamed: LED_ENET_ACT_.C, R5.2
unnamed: LED_WLAN_STATUS_.C, R6.2
unnamed: FX1.16, U$1.P13 (NC/EXT+)
unnamed: FX1.14, U$1.P11 (NC/EXT-)
unnamed: FX1.11, U$1.P19 (NC/ERX+)
unnamed: FX1.9, U$1.P17 (NC/ERX-)
unnamed: FX1.1, J2-.4
unnamed: FX1.3, J2-.3
unnamed: FX1.8, J2-.1
unnamed: FX1.6, J2-.2
unnamed: J1.6 (RX1), R1.2
unnamed: J1.5 (TX1), R2.2
RTS1: J1.17 (GP0), U$1.P5 (RTS1)
RXD1: J1.3 (TX0), U$1.P7 (RXD1)
RXD2: JP2.2, U$1.P23 (RXD2)
TXD1: J1.4 (RX0), U$1.P10 (TXD1)
TXD2: JP1.1, U$1.P25 (TXD2)
VCC: C2.1, J1.1 (3.3V), LED_3V3_.A, LED_ENET_ACT_.A, LED_ENET_LINK_.A, LED_WLAN_STATUS_.A, U$1.P29 (3V3), U$1.P31 (3V3), U$1.P33 (3V3)
WLAN: R6.1, U$1.P4 (LED1/WLAN_LED)

Board: 2 copper layers, 25 parts (2 on the bottom side), 29 nets, no tracks yet.
