Engineering-3/RCM-Comm/RCM-Comm_v1/RCM-Comm_v1_no_ethernet.brd

## EAGLE design RCM-Comm_v1/RCM-Comm_v1_no_ethernet.brd (2015-11-02, an earlier design)

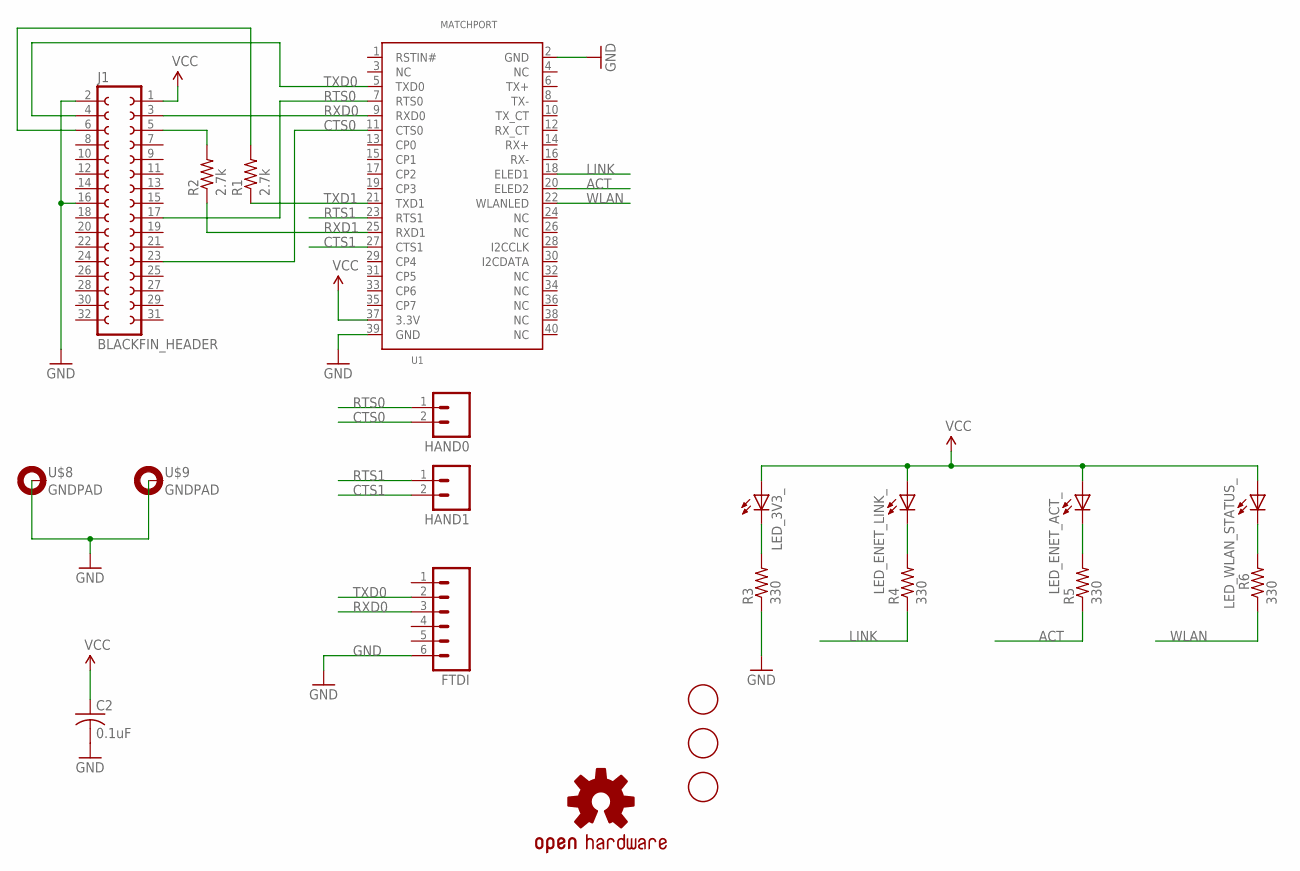
[picture p28: schematic RCM-Comm_v1_no_ethernet.sch]

Parts:
C2: 0.1uF; C0603
FID1, FID2, FID3: FIDUCIAL; FIDUCIAL_1MM
FTDI: M06SIP; 1X06
HAND0, HAND1: M02PTH; 1X02
J1: BLACKFIN_HEADER; 2X16
LED_3V3_: LED0603; LED-0603
LED_ENET_ACT_: LED0603; LED-0603
LED_ENET_LINK_: LED0603; LED-0603
LED_WLAN_STATUS_: LED0603; LED-0603
LOGO1: OSHW-LOGOM; OSHW-LOGO-M
R1, R2: 2.7k; 0207/10
R3, R4, R5, R6: 330; 0603-RES
U1: MATCHPORT; MATCHPORT_LAYOUT
U$3: ROHS_GARBAGE; ROHS_GARBAGE_5MM
U$8, U$9: GNDPAD

Connections:
ACT: R5.1, U1.20 (ELED2)
CTS0: HAND0.2, J1.23 (GP6), U1.11 (CTS0)
CTS1: HAND1.2, U1.27 (CTS1)
GND: C2.2, FTDI.6, J1.2 (GND), J1.16 (GND16), R3.1, U1.2 (GND), U1.39 (GND), U$8.P$1, U$9.P$1
LINK: R4.1, U1.18 (ELED1)
unnamed: LED_3V3_.C, R3.2
unnamed: LED_ENET_LINK_.C, R4.2
unnamed: LED_ENET_ACT_.C, R5.2
unnamed: LED_WLAN_STATUS_.C, R6.2
unnamed: J1.6 (RX1), R1.2
unnamed: J1.5 (TX1), R2.2
RTS0: HAND0.1, J1.17 (GP0), U1.7 (RTS0)
RTS1: HAND1.1, U1.23 (RTS1)
RXD0: FTDI.3, J1.3 (TX0), U1.9 (RXD0)
RXD1: R2.1, U1.25 (RXD1)
TXD0: FTDI.2, J1.4 (RX0), U1.5 (TXD0)
TXD1: R1.1, U1.21 (TXD1)
VCC: C2.1, J1.1 (3.3V), LED_3V3_.A, LED_ENET_ACT_.A, LED_ENET_LINK_.A, LED_WLAN_STATUS_.A, U1.37 (3.3V)
WLAN: R6.1, U1.22 (WLANLED)

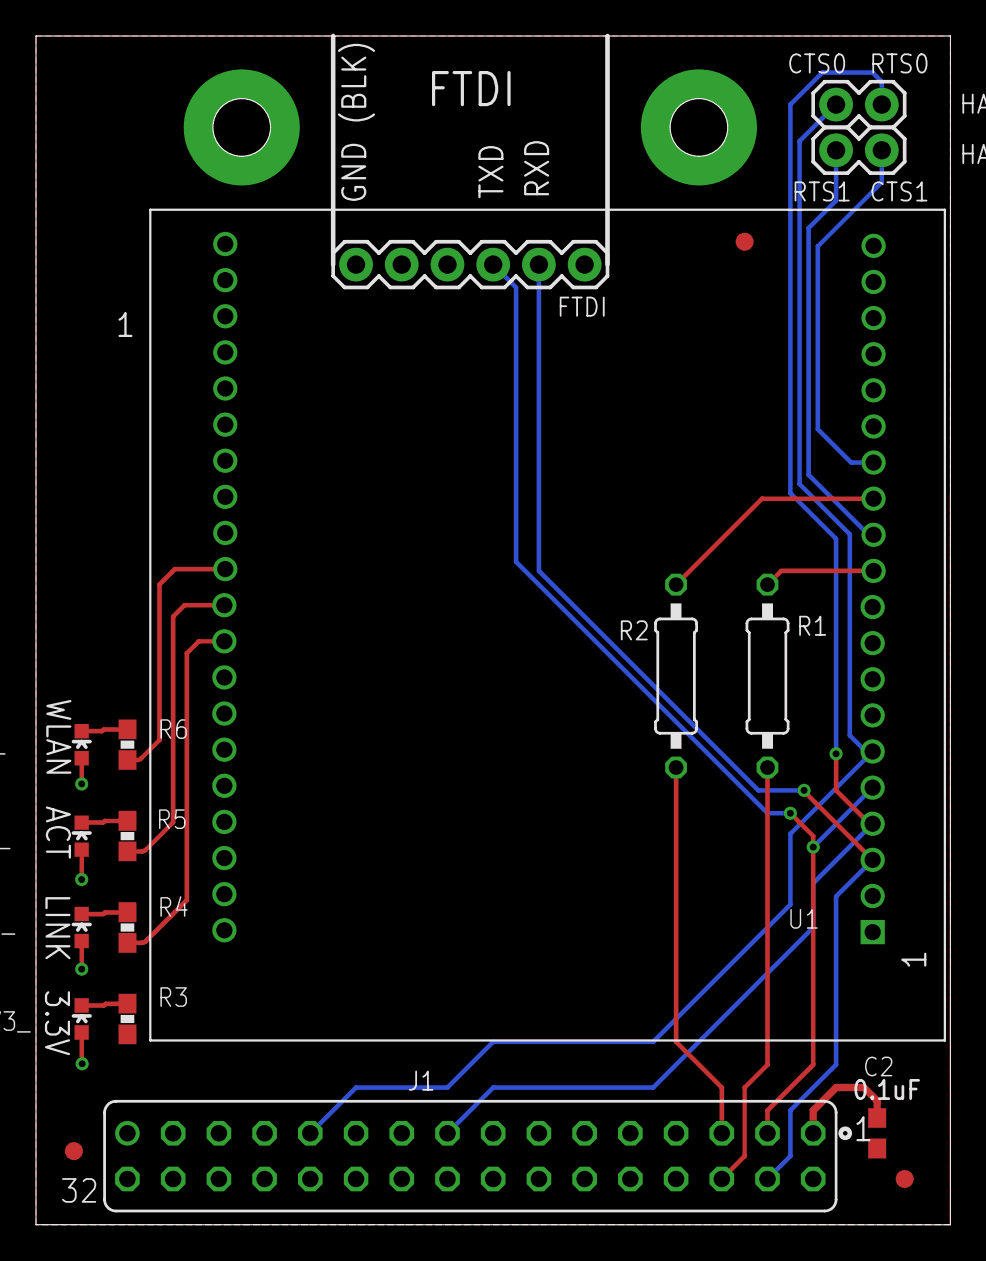
[picture p29: board RCM-Comm_v1_no_ethernet.brd from above]

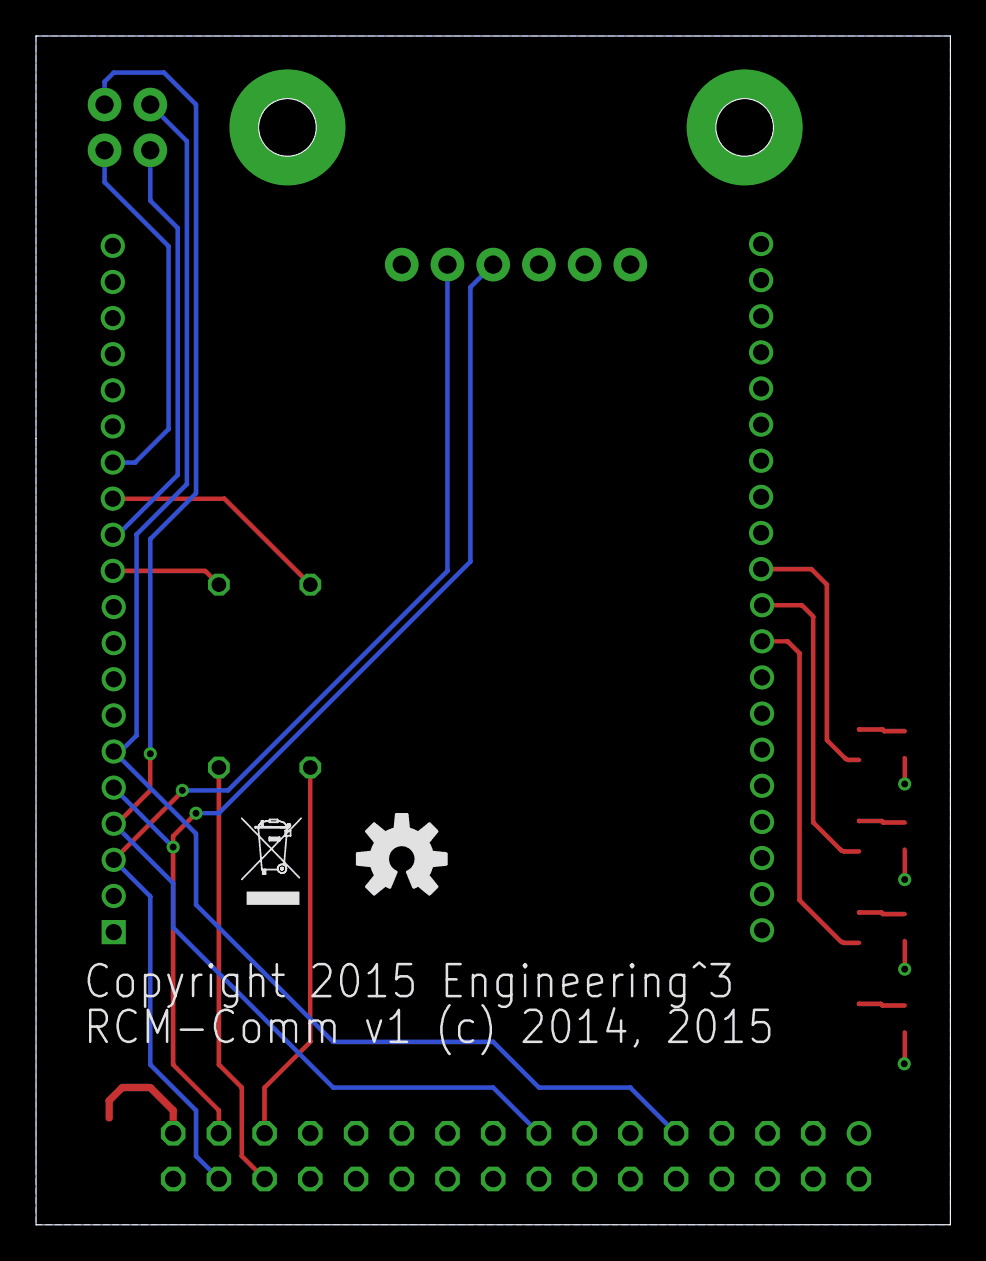
[picture p30: board RCM-Comm_v1_no_ethernet.brd from below]

Board: 2 copper layers, 50.8 x 66.0 mm, 23 parts (2 on the bottom side), 19 nets.
