Engineering-3/RCM-Comm/(commit log)

2015-02-14 Initial checkin of files from Logic.
    [RCM-comm_v1-BOM.xls, RCM-comm_v1.brd, RCM-comm_v1.sch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]
2015-02-16 Updated file names and added details to board and schematic.
    [RCM-Comm_v1.brd, RCM-Comm_v1.sch, RCM-comm_v1.brd, RCM-comm_v1.sch]
2015-11-02 New version of board without Ethernet connector (and thus a true rectangle shape.)
    [RCM-Comm_v1_no_ethernet.brd, RCM-Comm_v1_no_ethernet.sch]
2016-01-24 Started xPico version of RCM-Comm board.
    [RCM-CommX1-BOM.xls, RCM-CommX1.brd, RCM-CommX1.sch]
2016-02-05 Version 2.0 of RCM-Comm board ready for review.
    [RCM-CommV2-BOM.xls, RCM-CommV2.brd, RCM-CommV2.sch]
2016-02-05 Folder name change.
    [RCM-CommV2-BOM.xls, RCM-CommV2.brd, RCM-CommV2.sch]
2016-02-05 Fixed attribution text in schematic.
    [RCM-CommV2.sch]
2016-02-06 Updated BOM for v2 of board.
    [RCM-CommV2-BOM.xls, RCM-CommV2.brd]
2016-03-10 Added text to back silk.
    [RCM-CommV2.brd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]
2016-03-10 Renaming to _W
    [RCM-CommV2-BOM.xls, RCM-CommV2.brd, RCM-CommV2.sch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]
2016-03-10 Renaming to add _W
    [RCM-Comm_v2_W-BOM.xls, RCM-Comm_v2_W.brd, RCM-Comm_v2_W.sch]
2016-03-14 Updated 2x16 connector with new part number (reduces space between BFin and Comm board)
    [RCM-Comm_v2_W-BOM.xls]
2016-05-30 V3 of the RCM-Comm Board * Moved mounting holes
    [RCM-Comm_v3_W.brd, RCM-Comm_v3_W.sch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]
2016-08-01 Adding board build readme.
    [RCM-Comm_v1_no_ethernet.GBL, RCM-Comm_v1_no_ethernet.GBO, RCM-Comm_v1_no_ethernet.GBP, RCM-Comm_v1_no_ethernet.GBS, RCM-Comm_v1_no_ethernet.GTL, RCM-Comm_v1_no_ethernet.GTO, RCM-Comm_v1_no_ethernet.GTP, RCM-Comm_v1_no_ethernet.GTS]
2016-08-18 Updated positions of component reference designators on the board, and created pdf of board file
    [RCM-Comm_v3_W.brd]
2018-12-23 RCM-COmm_v4 (a) design complete. Gerbers ready for fab pending approval.
    [RCM-Comm_v4.brd, RCM-Comm_v4.sch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]
2018-12-24 Added DEFAULT ENABLE header back in, re-rendered top and bottom for approval.
    [RCM-Comm_v4.brd, RCM-Comm_v4.sch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]
2018-12-29 Added WLAN Led on configurable pin (CP) #1.
    [RCM-Comm_v4.brd, RCM-Comm_v4.sch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]
2018-12-31 Fixed silk screen text on bottom of board (removed "W")
    [RCM-Comm_v4.brd]
2019-01-02 Started BOM
    [RCM-Comm_v4_BOM.xlsx]
2019-01-02 Updated final BOM. Final 'd' version of gerbers, which got sent to JLCPCB.
    [RCM-Comm_v4.brd, RCM-Comm_v4.sch, RCM-Comm_v4_BOM.xlsx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]
2019-03-16 Starting work on RCM-Comm_v3_E (Ethernet)
    [RCM-Comm_v3_E.brd, RCM-Comm_v3_E.sch]
2019-03-16 Got Ethernet version of RCM-Comm_v3 board pretty much done. Out for Tim's review.
    [RCM-Comm_v3_E-BOM.xlsx, RCM-Comm_v3_E.brd, RCM-Comm_v3_E.sch]
