Engineering-3/RCM-Comm/(notices)

Notices in the files:
RCM-Comm_v4/RCM-Comm_v4.brd:
E^3 RCM-Comm v4 (c) 2018
RCM-Comm_v1/RCM-Comm_v1.brd:
Copyright 2015 Engineering^3
RCM-Comm v1 (c) 2014, 2015
RCM-Comm_v2_W/RCM-Comm_v2_W.sch:
Copyright 2016 Engineering^3 LLC Copyright and related rights are licensed under the Solderpad Hardware License,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
RCM-Comm_v3_E/RCM-Comm_v3_E.brd:
E^3 RCM-Comm_E v3 (c) 2019
RCM-Comm_v1/RCM-Comm_v1_no_ethernet.sch:
Copyright 2015 Engineering^3 LLC
Copyright 2015 Engineering^3 LLC Copyright and related rights are licensed under the Solderpad Hardware License,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
RCM-Comm_v2_W/RCM-Comm_v2_W.brd:
E^3 RCM-Comm_W v2.0 (c) 2016
parts and their libraries:
SparkFun-Aesthetics: Licensing: Creative Commons ShareAlike 4.0 International - https://creativecommons.org/licenses/by-sa/4.0
